FelixAntoine0708/projet_Formule_SAE/README.md

# PROJET FORMULE SAE AFFICHAGE (UdeS)
Le projet SAE pour UdeS Affichage

MicrosoftTeams-image

## Qu'est-ce qui si trouve
* A23 - Dossier qui contient ce que nous avons fait à la session d'autonme 2023 
* H24 - Dossier qui contient ce que nous avons fait à la session d'hiver 2024 
* Manuel_technique_CANVision_FINAL - Le manuel technique en PDF, docx et l'Evaluation des Couts du CANVision
