FelixAntoine0708/projet_Formule_SAE/H24/MATERIEL/README.md

* PCB : Contient le PDF et le fichier STEP 

* Boitier : Toutes les parties du boitier  

* Écran : Schéma électrique de l'écran, fiche technique de la famille d'écran Gen4-ESP32-RGB-Series et fiche technique du tca9554a.

* ESP32_S3R8 : Fiche technique et le manuel de référence technique du ESP32-S3.
