FelixAntoine0708/projet_Formule_SAE/H24/LOGICIEL/AFFICHAGE_SAE/README.md

# AFFICHAGE_SAE

## Ce qu'il contient

* AFFICHAGE_SAE_CAN_DESUET_ : Contiens la première version de l'affichage final qui est Désuet.

* DEMO_AFFICHAGE_POUR_UNI : Les démos d'affichages qui ont été montrés aux membres de l'université.

* Code_Final_CANVision_V1_FA : Code de l'affichage SAE final.

> [!TIP]  
> Dans les fichier de code il contient:
> * `4dArdUsd`:  Ficher d'extension graphique en Arduino
> * `4Dino` : Fichier de code de 4D system
> * `dat` : Fichier qui contient la position des widget sur l'écran en plain text
> * `gci` : Fichier qui contient la position des widget sur l'écran
> * `ino` : Fichier de code d'Arduino
> * `h` : Fichier qui contient les widgets sur l'écran uniquement
