FelixAntoine0708/projet_Formule_SAE/H24/MATERIEL/PCB/README.md

# PCB
PCB
## Ce qui contient

* _**PDF**_ : dossier qui contient les pieces du PCB `TJA1051T/3, 118`, `LM2675` et `ATM13-4P-BPM02`

* _**Fichier_Altium_PCB_V2**_ : Dossier qui contient les fichier pour voir dans Altium le PBC.

* _**PCB_V2_Final**_ : Dossier de fichier sources du PCB
