FelixAntoine0708/projet_Formule_SAE/H24/MATERIEL/Boitier/README.md

# Boitier
Boitier

## Ce qu'il si trouve

* _**3mf**_ : Dossier qui contient des fichier 3mf pour l'impression 3D

* _**STL**_ : Dossier qui contient des fichier STL pour la visualisation 3D
