FelixAntoine0708/projet_Formule_SAE/A23/CODE_PROJET/CAN_ESP32_PI/README.md

## Projet Final 
## Contenu

> [!NOTE]
> Le dossier ESP32 s'utilise sur **PlatformIO** <br />
> <br />
> ***include, lib, test*** <br />
> Ces dossiers n'ont rien à l'intérieur

* ESP32 - Dossier qui contient le code du ESP32-C3 Fonctionnel et Non fonctionnel 
* RASPBERRY_PI - Dossier qui contient le code du Rapsberry Pi Fonctionnel et Non fonctionnel
