FelixAntoine0708/projet_Formule_SAE/A23/CODE_PROJET/SPI_ESP32_PI/README.md

# Contenu
* CODE_FONCTIONNELLE
* CODE_NON_FOCTIONNELLE

> [!NOTE]
> C'est dossier, aux noms explicites, sont autant pour le ESP32-C3 que le Pi 3B.
