FelixAntoine0708/projet_Formule_SAE/H24/LOGICIEL/AFFICHAGE_SAE/DEMO_AFFICHAGE_POUR_UNI/README.md

# AFFICHAGE_SAE

## Ce qu'il contient

* AFFICHAGE_SAE_V1_ME_Gendron-Fontaine : Premier Affichage ME (DÉSUET)

* Code_Affichage_SAE_V1_FA_Guimont : Premier Affichage FA

* AFFICHAGE_SAE_V2 : Contiens le code d'une deuxième version de l'affichage SAE de M-E.

* Code_Affichage_SAE_V1_FA_Guimont_MODIF : Premier Affichage FA où les bogues sont corrigés

> [!TIP]  
> Dans les fichier de code il contient:
> * `4dArdUsd`:  Ficher d'extension graphique en Arduino
> * `4Dino` : Fichier de code de 4D system
> * `dat` : Fichier qui contient la position des widget sur l'écran en plain text
> * `gci` : Fichier qui contient la position des widget sur l'écran
> * `ino` : Fichier de code d'Arduino
> * `h` : Fichier qui contient les widgets sur l'écran uniquement
