FelixAntoine0708/projet_Formule_SAE/A23/CODE_PROJET/SERIAL_ESP32_PI/NON_FONCTIONNELLE/README.md

Ici se retrouvent les codes du ESP32-C3 et du Pi 3B pour une tentative de communication en serial avec les GPIO rx et TX.
Le serial étant non fonctionnel sur le Pi, cette idée a été embandonnée.
