FelixAntoine0708/projet_Formule_SAE/A23/CODE_PROJET/CAN_ESP32_PI/ESP32/NON_FONCTIONNELLE/README.md

Ici se trouve un code similaire à celui du ESP32-C3. Ce code est fait pour le ESP32-S3 qui contient aussi les drivers TWAI.
Pour une raison inexpliquée, le ESP32-S3 ne peut pas se servir du TWAI malgré qu'il soit inclus dans la fiche technique.
