FelixAntoine0708/projet_Formule_SAE/A23/CODE_PROJET/CAN_ESP32_PI/ESP32/FONCTIONNELLE/README.md

Ici se trouve le code du ESP32-C3 qui permet à ce dernier d'envoyer des trames CAN avec l'aide des drivers TWAI. Ce
code contient une partie pour la transmission de trame CAN et une autre pour la réception de ceux-ci. C'est ce code
qui nous permet de faire fonctionner notre prototype. Ce code est basé sur le framework de espressif32.
