FelixAntoine0708/projet_Formule_SAE/A23/CODE_PROJET/SPI_ESP32_PI/CODE_NON_FONCTIONNELLE/RASPBERRY_PI/README.md

# Contenu
* SLAVE_PI_V2.py <br />
  tentatives pour communiquer en SPI avec le ESP32. Ils doivent afficher les trames reçues dans un terminal. Ils sont non fonctionnels parce que le Raspberry Pi ne peut pas être un slave.
  
* SPI_PI_SLAVE.py <br />
  tentatives pour communiquer en SPI avec le ESP32. Ils doivent afficher les trames reçues dans un terminal. Ils sont non fonctionnels parce que le Raspberry Pi ne peut pas être un slave. mettre le Pi en slave pour la communication en SPI. Nous avons découvert que le Pi ne peut être qu'un master.
  
* SPI_PI_MASTER.py <br />
  tentatives de mettre le Pi en master. transmettre 0xAA au ESP32-C3 dans l'espoir que celui-ci les reçoive et les affiche dans un terminal.
  
* MASTER_PI_V2.py <br />
  tentatives de mettre le Pi en master. fait la même chose à l'exception que l'utilisateur entre les données à envoyer (entre 0 et 255).
  
* SPI_PI.py <br />
  les tentatives de communication en SPI. Afficher les données reçues dans un terminal.
  
* SPI_PY_AFF.py <br />
  les tentatives de communication en SPI. Afficher les données reçues avec la librairie Turtle.
