FelixAntoine0708/projet_Formule_SAE/A23/CODE_PROJET/SPI_ESP32_PI/CODE_NON_FONCTIONNELLE/ESP32_C3/README.txt

        Ce dossier contient les codes non fonctionnels du ESP32-C3. Les codes ESP32_SLAVE et SPI_ESP32 sont faits avec le framework espressif32.
