FelixAntoine0708/projet_Formule_SAE/A23/CODE_PROJET/SPI_ESP32_PI/CODE_FONCTIONNELLE/ESP32_C3/slave_simple_task/README.txt

    Ce code est un des multiples exemples que Arduino IDE a à offrir. Il permet au ESP32-C3 de communiquer avec le Pi 3B en SPI.
    J'ai modifié le code pour qu'il envoie les trois caractères suivant : H, L, O. Le ESP32-C3 est le SLAVE.
