FelixAntoine0708/projet_Formule_SAE/H24/README.md

# Dossier Hiver 2024

* LOGICIEL : Contiens tous les codes du projet.
* MATERIEL : Contiens tout les informations pour le matériel
