FelixAntoine0708/projet_Formule_SAE/A23/README.md

<h1> Dossier d'autonme 2023</h1>

## Que contient le dossier
* CAN_ESPIDF - Dossier qui contient le code d'envoie de l'autre équipe
* CODE_PROJET - Dossier qui contient le code d'affichage de notre équipe (Affichage avec Pi)
