FelixAntoine0708/projet_Formule_SAE/H24/LOGICIEL/README.md

# Logiciel

## Ce qu'il contient

* AFFICHAGE_SAE : Contiens des codes d'affichage SAE (Plusieurs choix pour client)

* CODE_AFFICHAGE_ET_CAN_DÉSUET_ : Contiens toutes les fonctions pour fusionner le code de l'affichage et le code du CAN. (DÉSUET)

* CODE_DE_TEST : Contiens les codes servant à faire des tests de toutes sortes (Affichage et CAN).

* LIBRAIRIE : Contiens la librairie (en zip) GFX4dESP32 pour l'écran ESP32-70CT.

* PDF_Logiciel : Contiens un user guide pour le Workshop4 et le manuel de la librairie GFX4dESP32.

* ID_CAN : Contiens les ID du CAN.
