FelixAntoine0708/projet_Formule_SAE/A23/CODE_PROJET/README.md

# Contenu
* **CAN_ESP32_PI** <br />
Ce dossier est celui que le code final est à l'intérieur **(FINAL)**

* **SERIAL_ESP32_PI/NON_FONCTIONNELLE** <br />
Ce dossier est du code qui transmet le message CAN en Rx, Tx. Il n'est pas fonctionel **(Back-up)**

* **SPI_ESP32_PI** <br />
Ce dossier est du code qui transmet le message CAN en SPI seulement avec 2 TJA1050. Il n'est pas fonctionel **(Back-up)**

* **TEST_BTN_ET_AFFICHAGE_PI** <br />
Ce dossier est du code qui affiche le message avec le bouton aussi. **(Test)**
