FelixAntoine0708/projet_Formule_SAE/H24/LOGICIEL/CODE_AFFICHAGE_ET_CAN_DÉSUET_/README.md

* CAN_FCT.cpp et CAN_FCT.h : Ce fichier contient toutes les fonctions qui seront utiles au projet au niveau du CAN (lecture de la trame CAN, vérification de la trame CAN, affichage des informations, etc.)

* ID_CAPT.h : Contiens les ID des capteurs. (ID TEMPORAIRE)

* FCT_AFF.cpp et FCT_AFF.h : Contiens les fonctions utiles pour l'affichage (setup, affiche, update_affichage).

* CONST_AFF.h : Contiens les constantes utiles pour l'affichage (position en X et Y des boutons pour l'instant).

* 13_MARS_DESUET_ : Code désuet pour le CAN.

* 17_AVRIL_DESUET_ : Code désuet pour le CAN.

* 3_MAI_DESUET : Code désuet pour le CAN.

* 17_MAI_DESUET : Code désuet pour le CAN.
