FelixAntoine0708/projet_Formule_SAE/H24/LOGICIEL/ID_CAN/README.md

* ID_CAPT.h : Ce fichier d'entête contient toutes les constantes pour les capteurs. Les ID sont temporaires.
