FelixAntoine0708/projet_Formule_SAE/H24/LOGICIEL/AFFICHAGE_SAE/AFFICHAGE_SAE_CAN_DESUET_/README.md

* AFFICHAGE_SAE_CAN_V_0_0_1 : Première version de l'affichage finale. Fait par M_E.
