FelixAntoine0708/projet_Formule_SAE/H24/LOGICIEL/CODE_AFFICHAGE_ET_CAN_DÉSUET_/13_MARS_DESUET_/README.md

* CAN_FCT_MODIF.cpp : Ce fichier contient toutes les fonctions modifiées qui seront utiles au projet (lecture de la trame CAN, vérification de la trame CAN, affichage des informations, etc.). Les fonctions ont été modifiées pour les adapter à l'affichage utilisé. "verif_trame" et "affiche_data" ne sont pas utilisés pour l'instant.

* CAN_FCT_MODIFF.h : Ce fichier d'entête contient toutes les prototype de fonctions qui seront utiles au projet (lecture de la trame CAN, vérification de la trame CAN, affichage des informations, etc.). Les fonctions ont été modifiées pour les adapter à l'affichage utilisé. "verif_trame" et "affiche_data" ne sont pas utilisés pour l'instant.

* ID_CAPT.h : Ce fichier d'entête contient tous les ID des capteurs sous forme de constante. !!!!!!!POUR L'INSTANT, LES ID SONT TEMPORAIRES!!!!!!

* ID_CAPT_DRIVE.h : Ce fichier d'entête contient tous les ID utilisé par la drive sous forme de constante.
