FelixAntoine0708/projet_Formule_SAE/H24/LOGICIEL/AFFICHAGE_SAE/Code_Final_CANVision_V1_FA/Code_Final_CANVision_V1_FA.ImgData/images.bmp

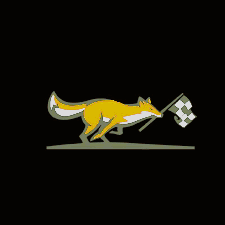
H24/LOGICIEL/AFFICHAGE_SAE/Code_Final_CANVision_V1_FA/Code_Final_CANVision_V1_FA.ImgData/images.bmp
