FelixAntoine0708/projet_Formule_SAE/H24/MATERIEL/PCB/PCB_V2_Final_/04 - ASSEMBLY/PCB_MCP_Final_BOM REV 2.00.xlsx

Bill of Material
Board | CAN_transciever |  | Concepteur Principal |  | Felix-Antoine Guimont |  |  | 2
Cours | Projet_Fin_DEC |  | Date du projet |  | 11 fevrier 2024 |  |  | 00
Département | Technologies du génie électrique |  | Date de génération du BOM |  | 4/14/2024
Révision | #NAME? |  | Heure de génération du BOM |  | 10:37 PM
Nombre de PCB | 1 |  | Variant |  | None
Item Number | Designator | Layer | Description | Comment | #Column Name Error:' Package / Case | #Column Name Error:' Supplier 1 | #Column Name Error:' Supplier Part Number 1 | Quantity | Quantity Total | #Column Name Error:' Note
 | C1, C8, C9 | Top | CAP ALUM 100UF 20% 50V SMD | 100 uF |  |  |  | 3 | #REF!
 | C2 | Top | Chip Capacitor, 10 nF, +/- 10%, 50 V, -55 to 125 degC, 0603 (1608 Metric), RoHS, Tape and Reel | 10 nF |  |  |  | 1 | #REF!
 | C3, C7 | Top | Automotive Ceramic Capacitor, 0805, 100nF, 10%, X7R, 15%, 100V | 0.1uF |  |  |  | 2 | #REF!
 | C4, J1, L1, R1, R2, R3, R4 | Top |  | 68 uF, ATM13-4P-BM02, 47uF, 10, 270, 120 |  |  |  | 7 | #REF!
 | C5, C6 | Top | CAP CER 100PF 50V C0G/NPO 0805 | 100 pF |  |  |  | 2 | #REF!
 | D1 | Top | LED GREEN CLEAR 0805 SMD | 10mA FC / 2.2VF |  |  |  | 1 | #REF!
 | D2 | Top | DIODE SCHOTTKY 40V 1A SOD123F | SS14FL |  |  |  | 1 | #REF!
 | J2 | Top | Flex Connector, 0.50mm Pitch, Height 2.00mm, Right angle, Slider type, ZIF, Upper contact, 30 position , Without MYLAR | F32Q-1A7H1-11030 |  |  |  | 1 | #REF!
 | R5 | Top | Chip Resistor, 1 KOhm, +/- 1%, 125 mW, -55 to 155 degC, 0805 (2012 Metric), RoHS, Tape and Reel | 1K |  |  |  | 1 | #REF!
 | U1 | Top | SIMPLE SWITCHER® Power Converter High Efficiency 1A Step-Down Voltage Regulator, 8-pin Narrow SOIC, Pb-Free | LM2675M-5.0/NOPB |  |  |  | 1 | #REF!
 | U2 | Top | High-Speed CAN Transceiver, 3 to 5 V, 8-Pin SOIC (SOT96-1), RoHS, Tape and Reel | TJA1051T/3,118 |  |  |  | 1 | #REF!
Commentaires ou instruction spécialies
