FelixAntoine0708/projet_Formule_SAE/H24/MATERIEL/Boitier/3mf/Porte_V1.3mf

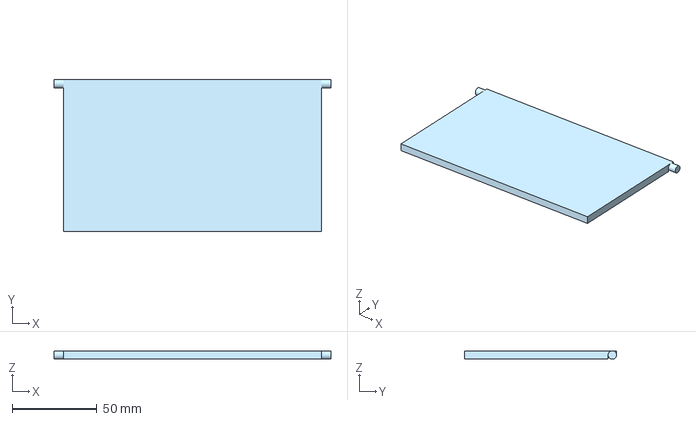
[picture p25: CAD file, 2024-02-28]
H24/MATERIEL/Boitier/3mf/Porte_V1.3mf
163.8 x 90.0 x 5.00 mm
