FelixAntoine0708/projet_Formule_SAE/H24/MATERIEL/Boitier/3mf/Boitier_V1.3mf

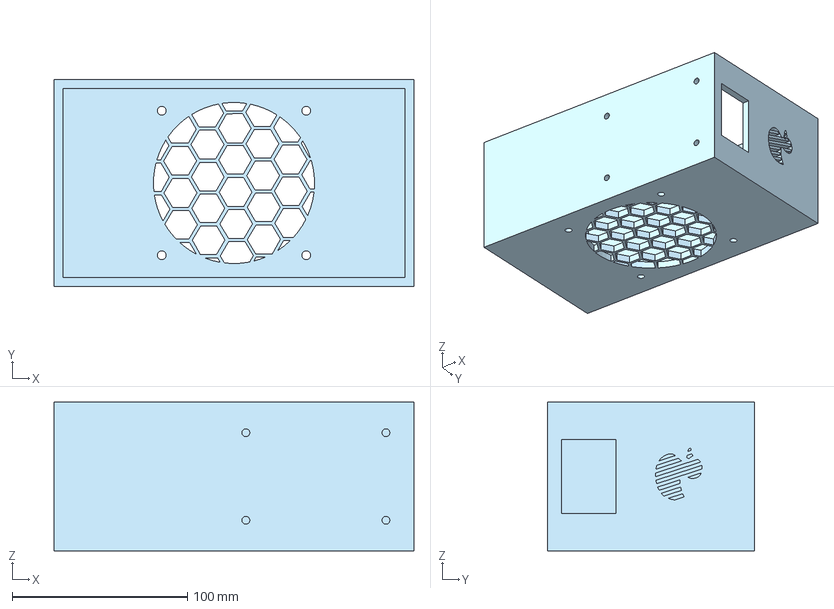
[picture p26: CAD file, 2024-02-28]
H24/MATERIEL/Boitier/3mf/Boitier_V1.3mf
205.6 x 118.1 x 85.0 mm
