FelixAntoine0708/projet_Formule_SAE/H24/MATERIEL/Boitier/3mf/Devant_V1.3mf

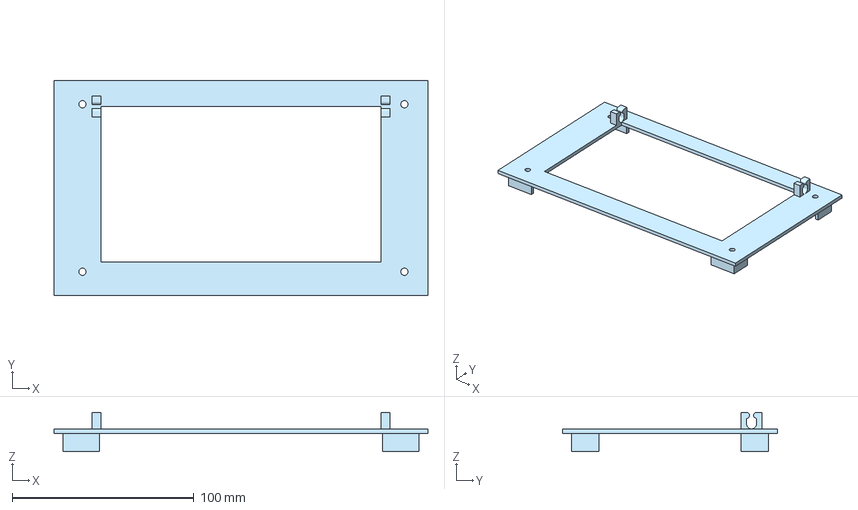
[picture p27: CAD file, 2024-02-28]
H24/MATERIEL/Boitier/3mf/Devant_V1.3mf
205.6 x 118.1 x 21.5 mm
