FelixAntoine0708/projet_Formule_SAE/(list of files, cad)

Other CAD files:
H24/MATERIEL/Boitier/STL/Boitier_V1.stl
H24/MATERIEL/Boitier/STL/Devant_V1.stl
H24/MATERIEL/Boitier/STL/Porte_V1.stl
H24/MATERIEL/PCB/PCB_V2_Final_/05 - 3D MODEL/PCB_MCP_Final_PCB REV 2.00.x_t
