FelixAntoine0708/projet_Formule_SAE/H24/LOGICIEL/CODE_DE_TEST/CODE_PICASO_CORRIGER_TEST_AFFICHAGE/README.md

Ici se trouve le dossier "TEST_AFF_PICASO" qui contient le code de test de l'affichage uLCD-32PT.

Le code se trouve dans le fichier "NoName1.4Dg".

Noname1.4Dg est un programme d'exploration des capacités du logiciel "4D Workshop 4 IDE". En gros, ce programme
affiche un thermomètre et une switch. Quand nous touchons la switch, le thermomètre affichera soit 100 C ou 10 C.
La switch est activé en touchant l'écran tactile. Il y a un label qui affiche la dernière position en x connus.
