FelixAntoine0708/projet_Formule_SAE/H24/LOGICIEL/CODE_DE_TEST/TEST_FPS/README.md

#TEST_FPS

## Ce qu'il contient

* TEST_FPS : Le premier code pour observer la fluidité de l'écran. Le fichier des widgets (le .cgi) fait environ 60 Mb.
