FelixAntoine0708/projet_Formule_SAE/H24/MATERIEL/PCB/PCB_V2_Final_/04 - ASSEMBLY/PCB_MCP_Final_PCB ASSEMBLY REV 2.00.PDF

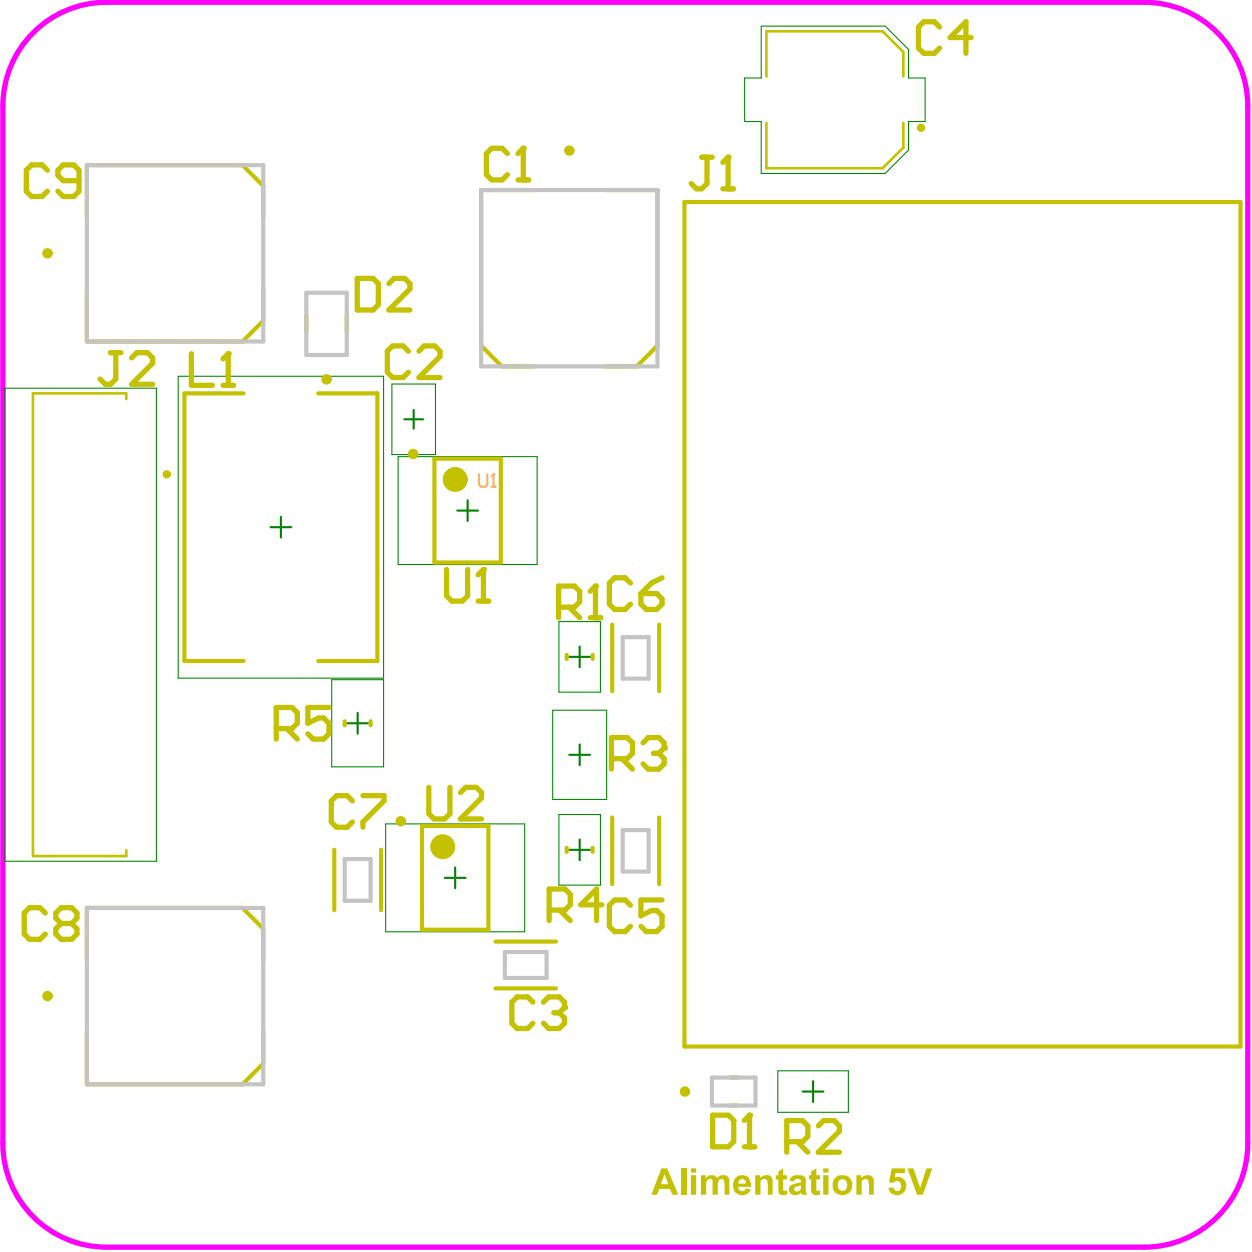
[picture p28: page 1]

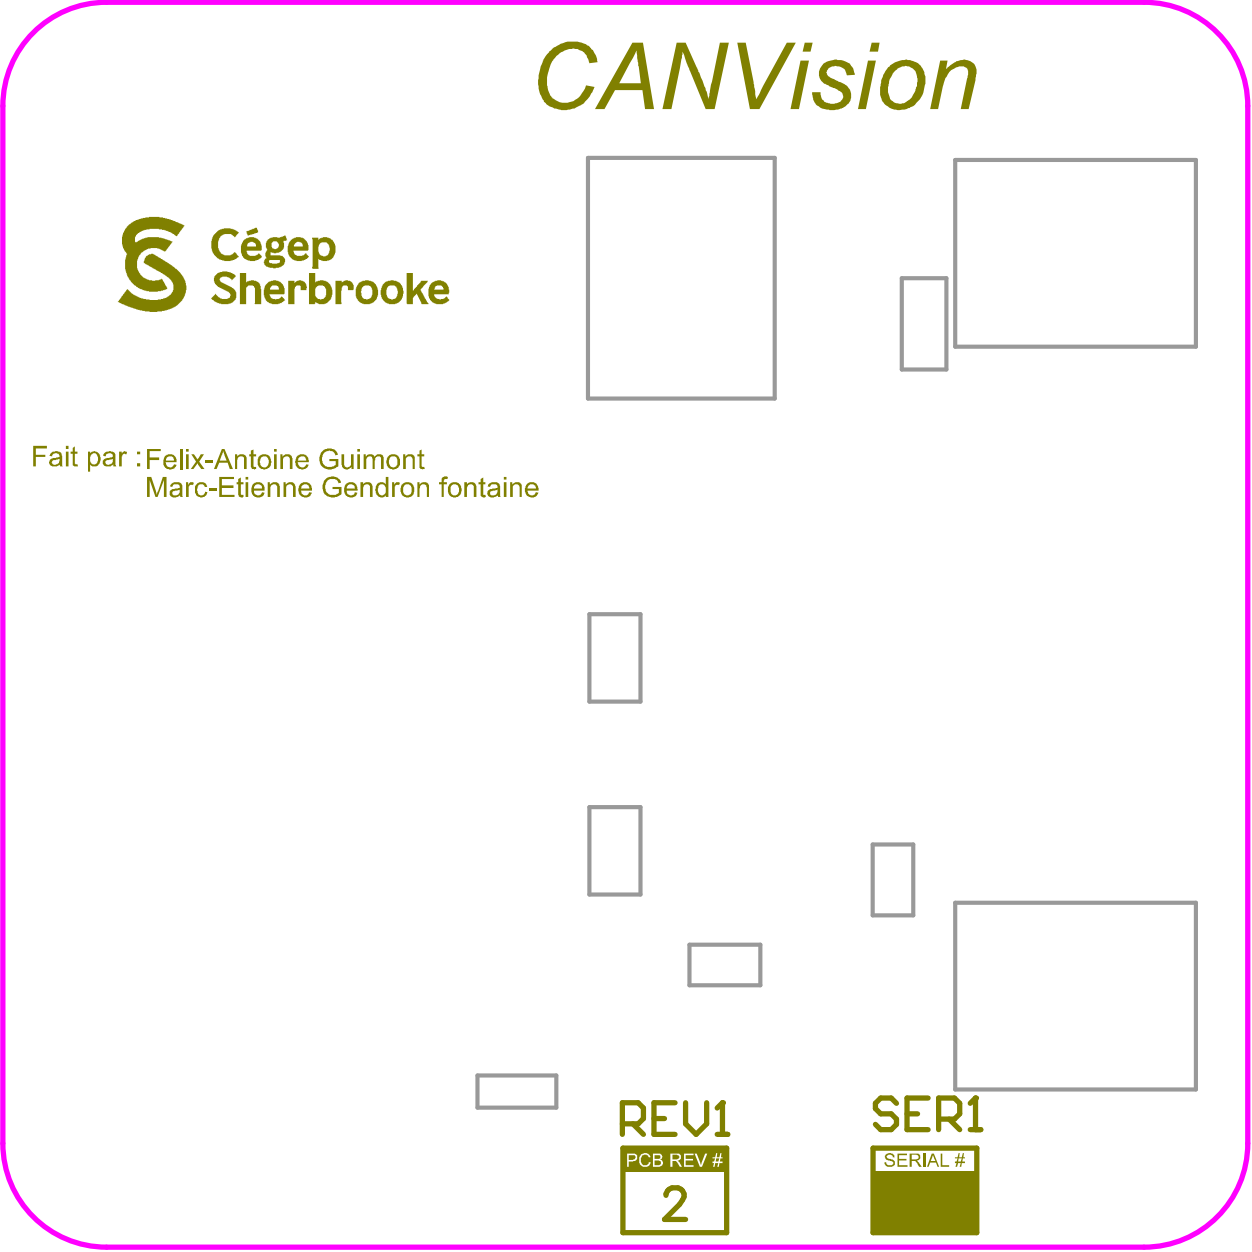
[picture p29: page 2]

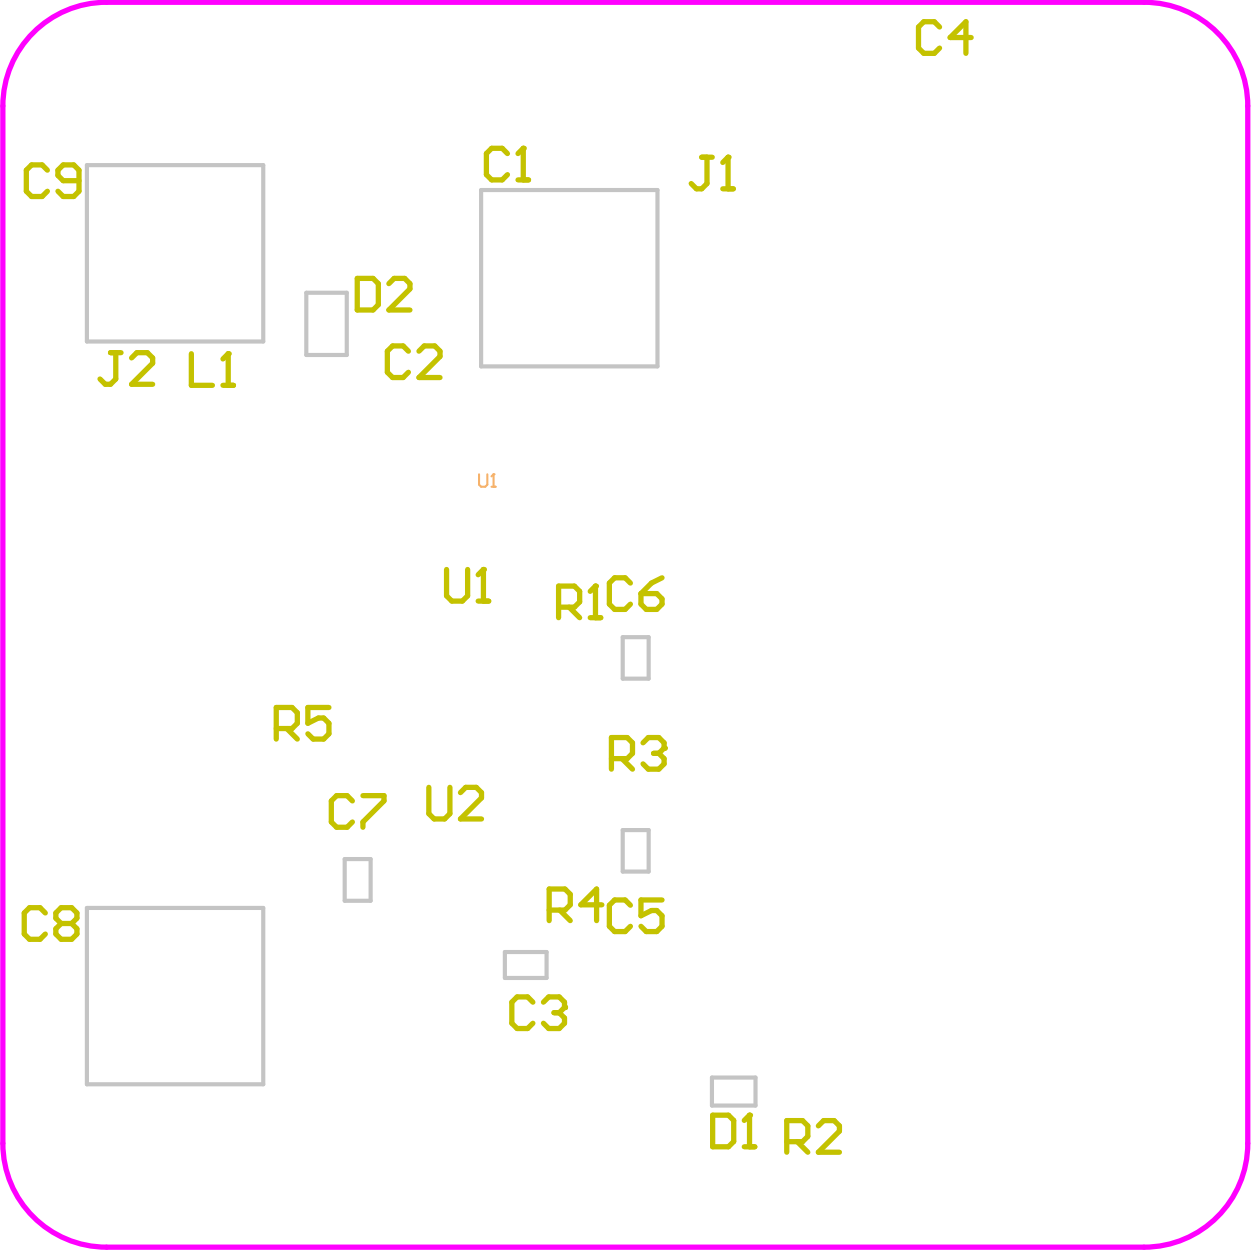
[picture p30: page 3]

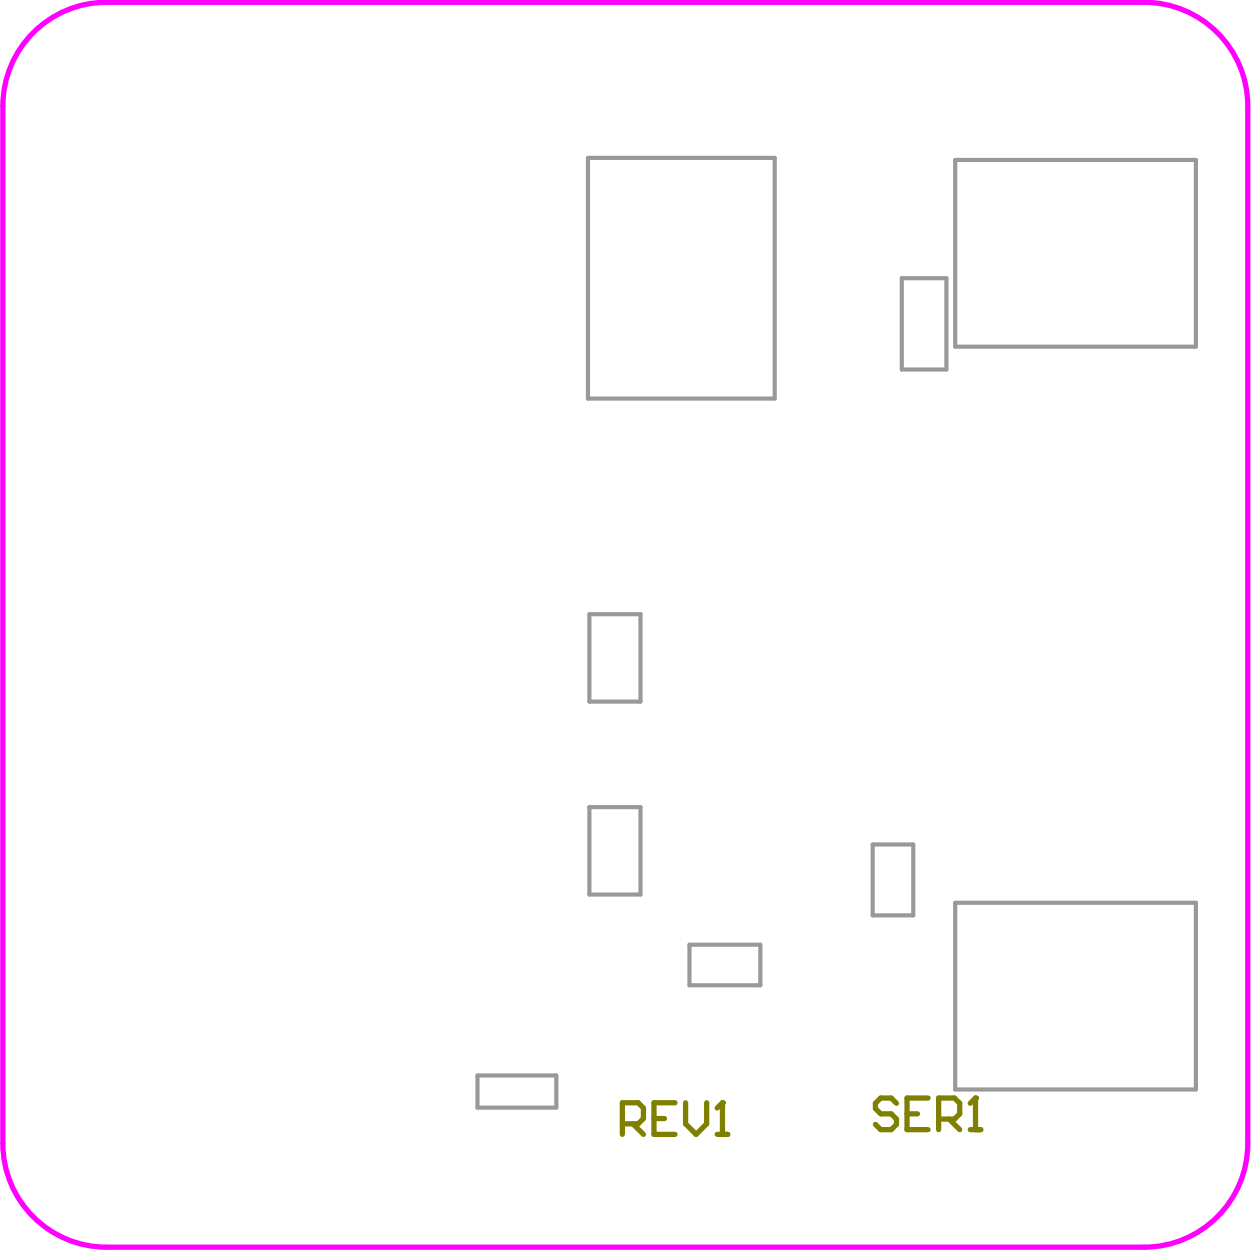
[picture p31: page 4]

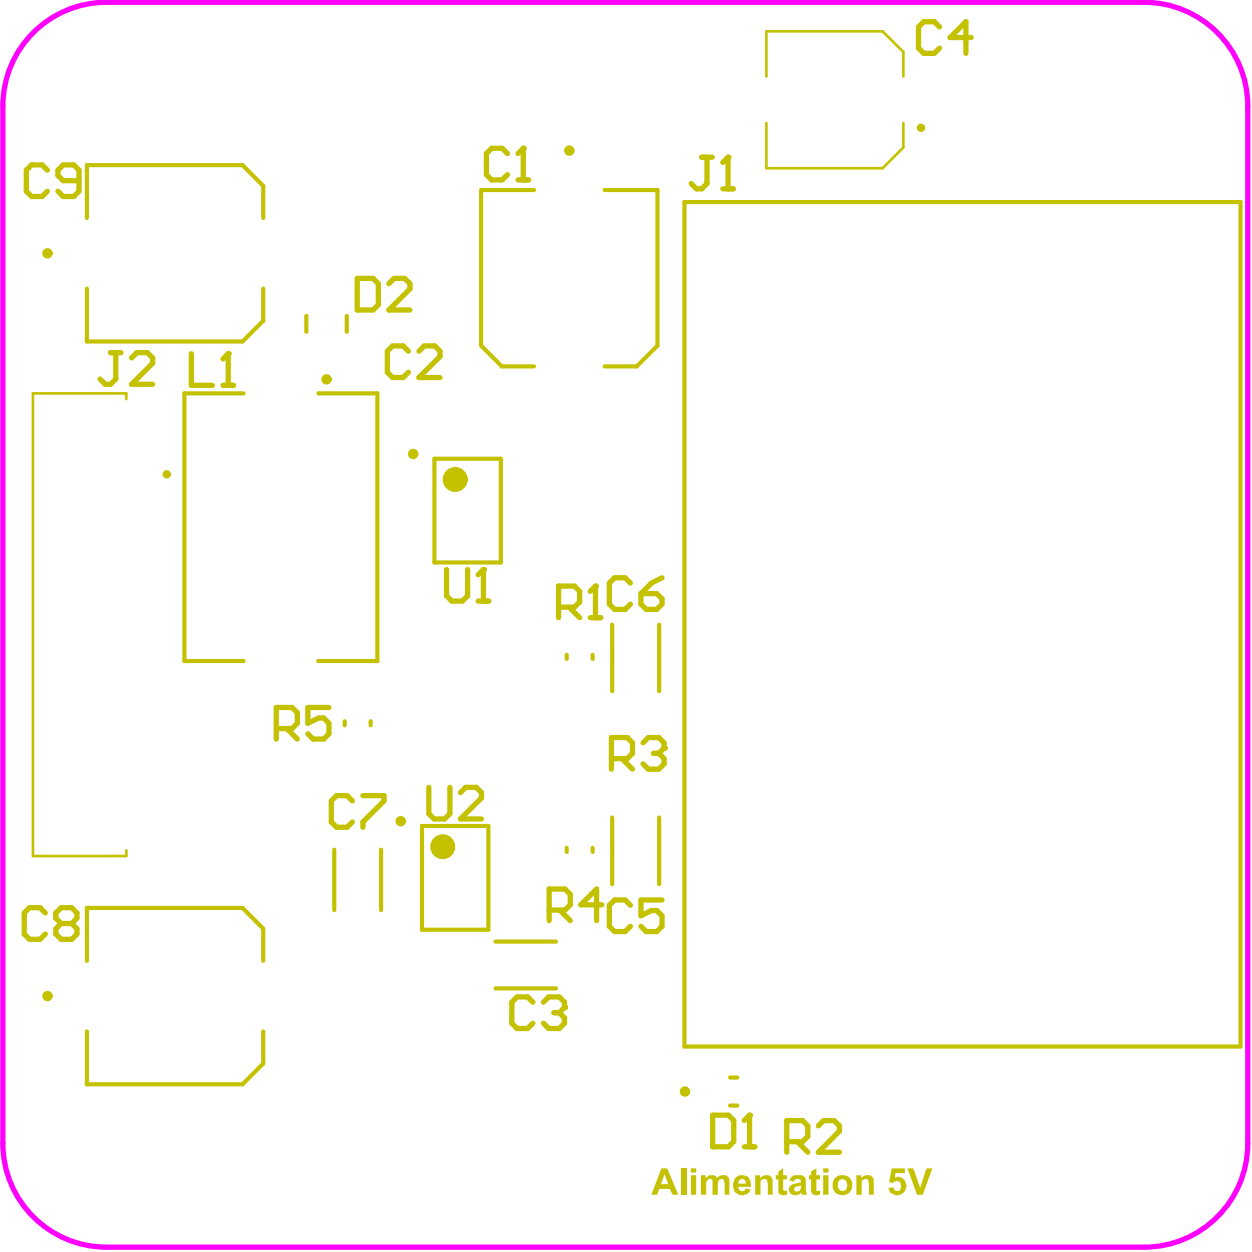
[picture p32: page 5]

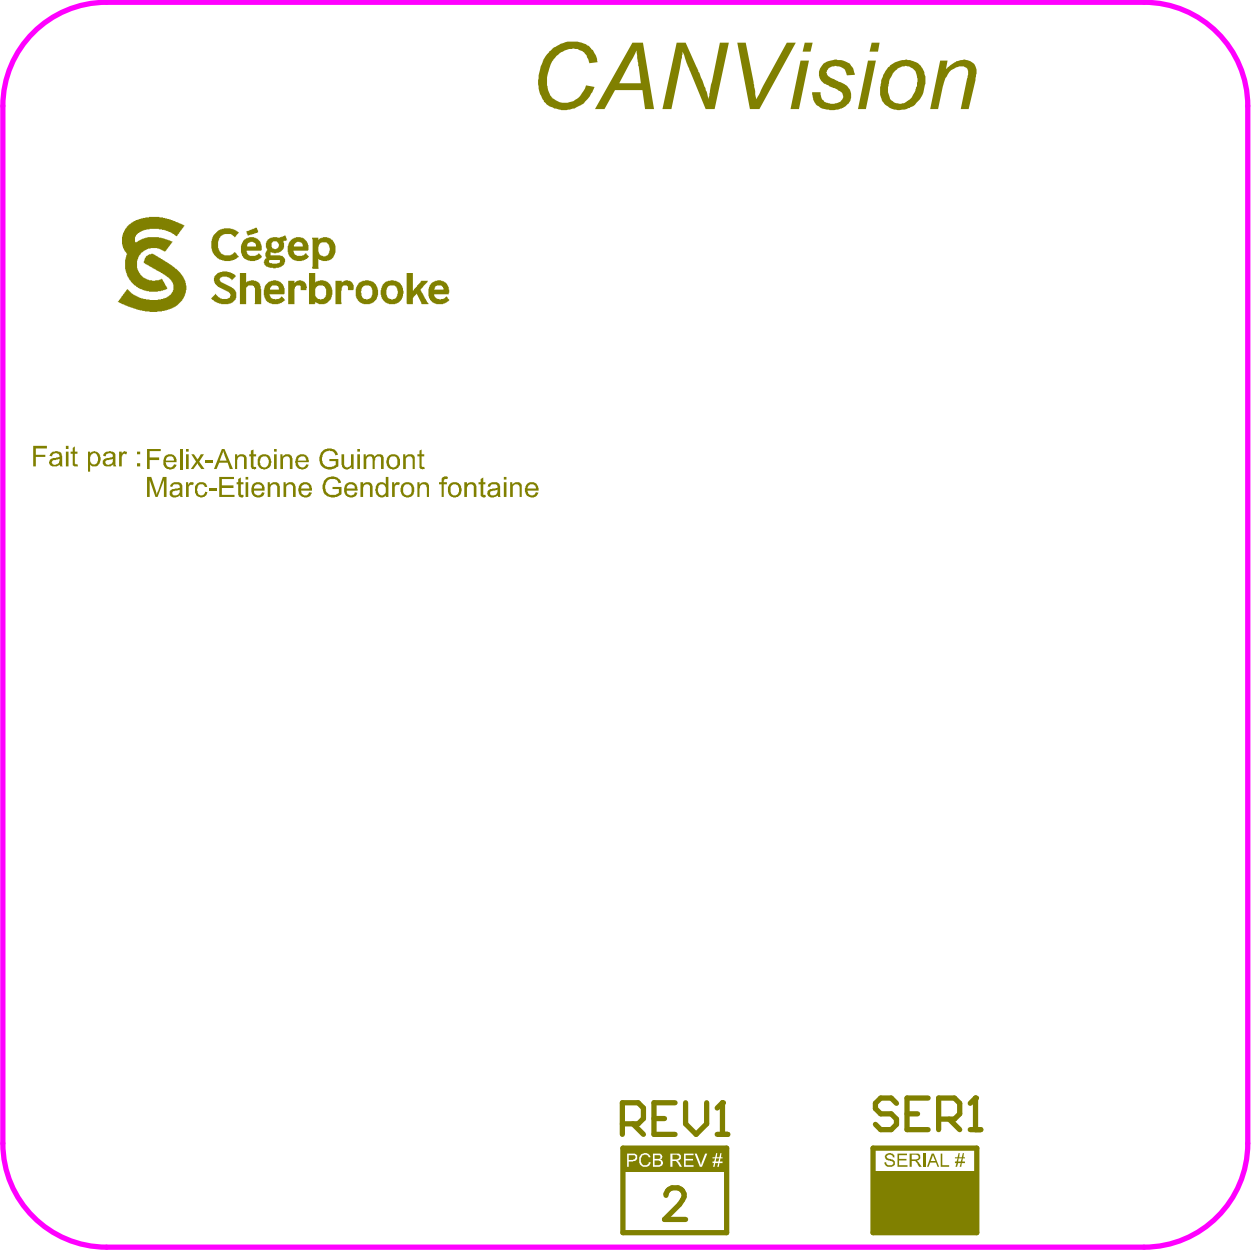
[picture p33: page 6]

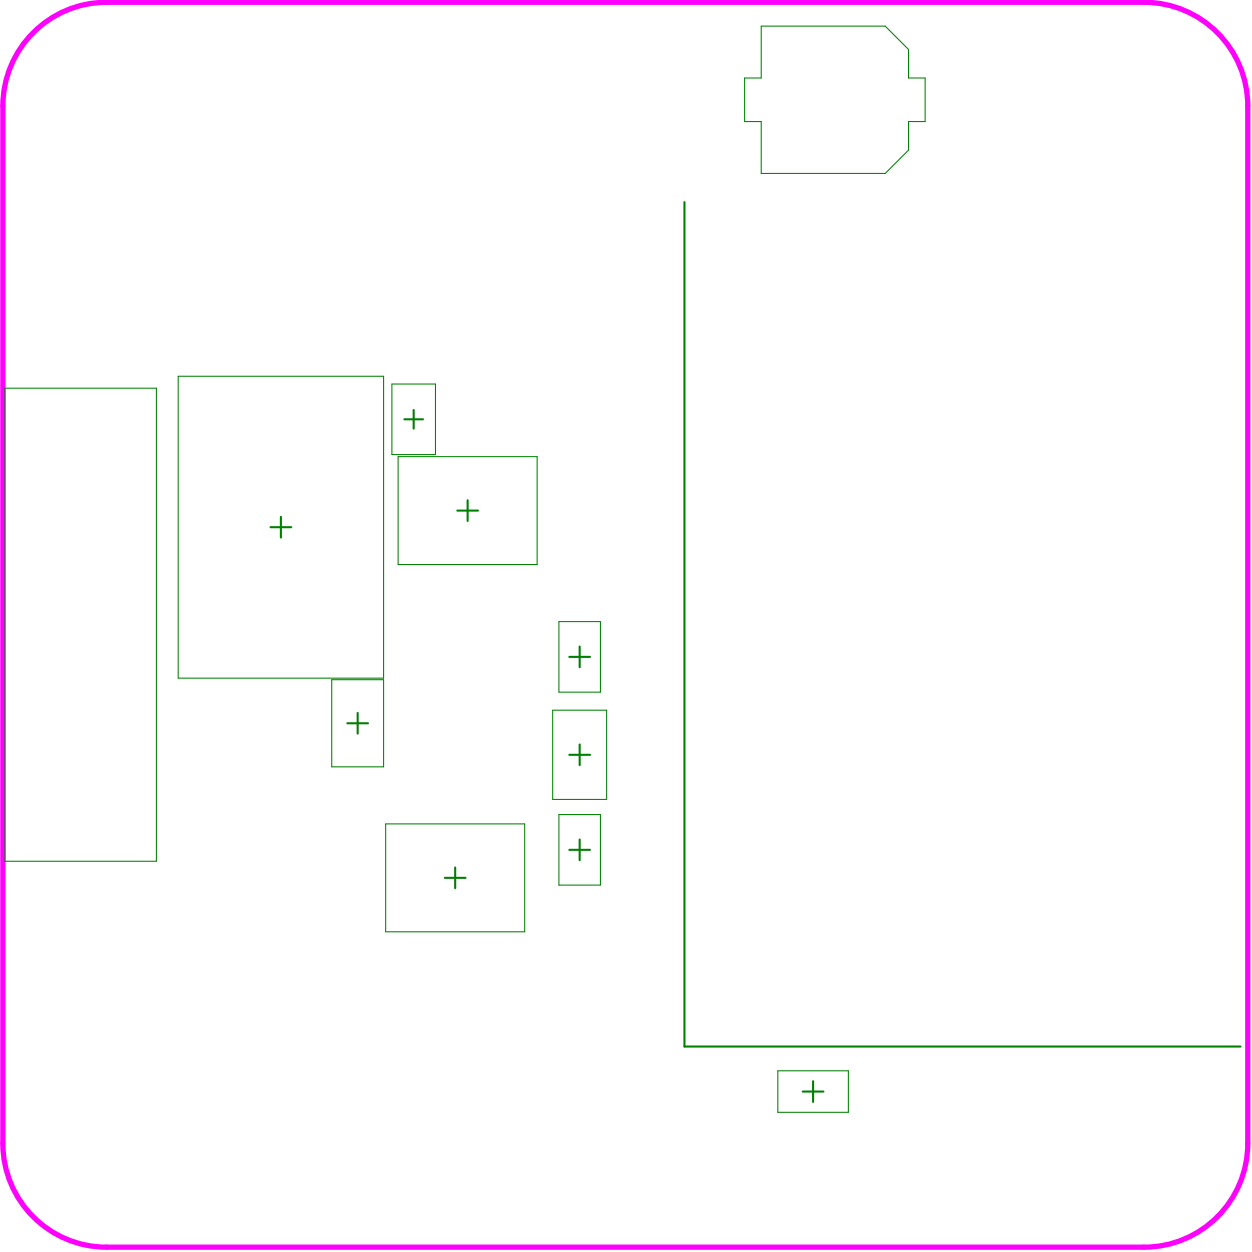
[picture p34: page 7]
