FelixAntoine0708/projet_Formule_SAE/H24/MATERIEL/PCB/PCB_V2_Final_/01-3 - STENCIL FAB/PCB_MCP_Final_STENCIL PRINT REV 2.00.PDF

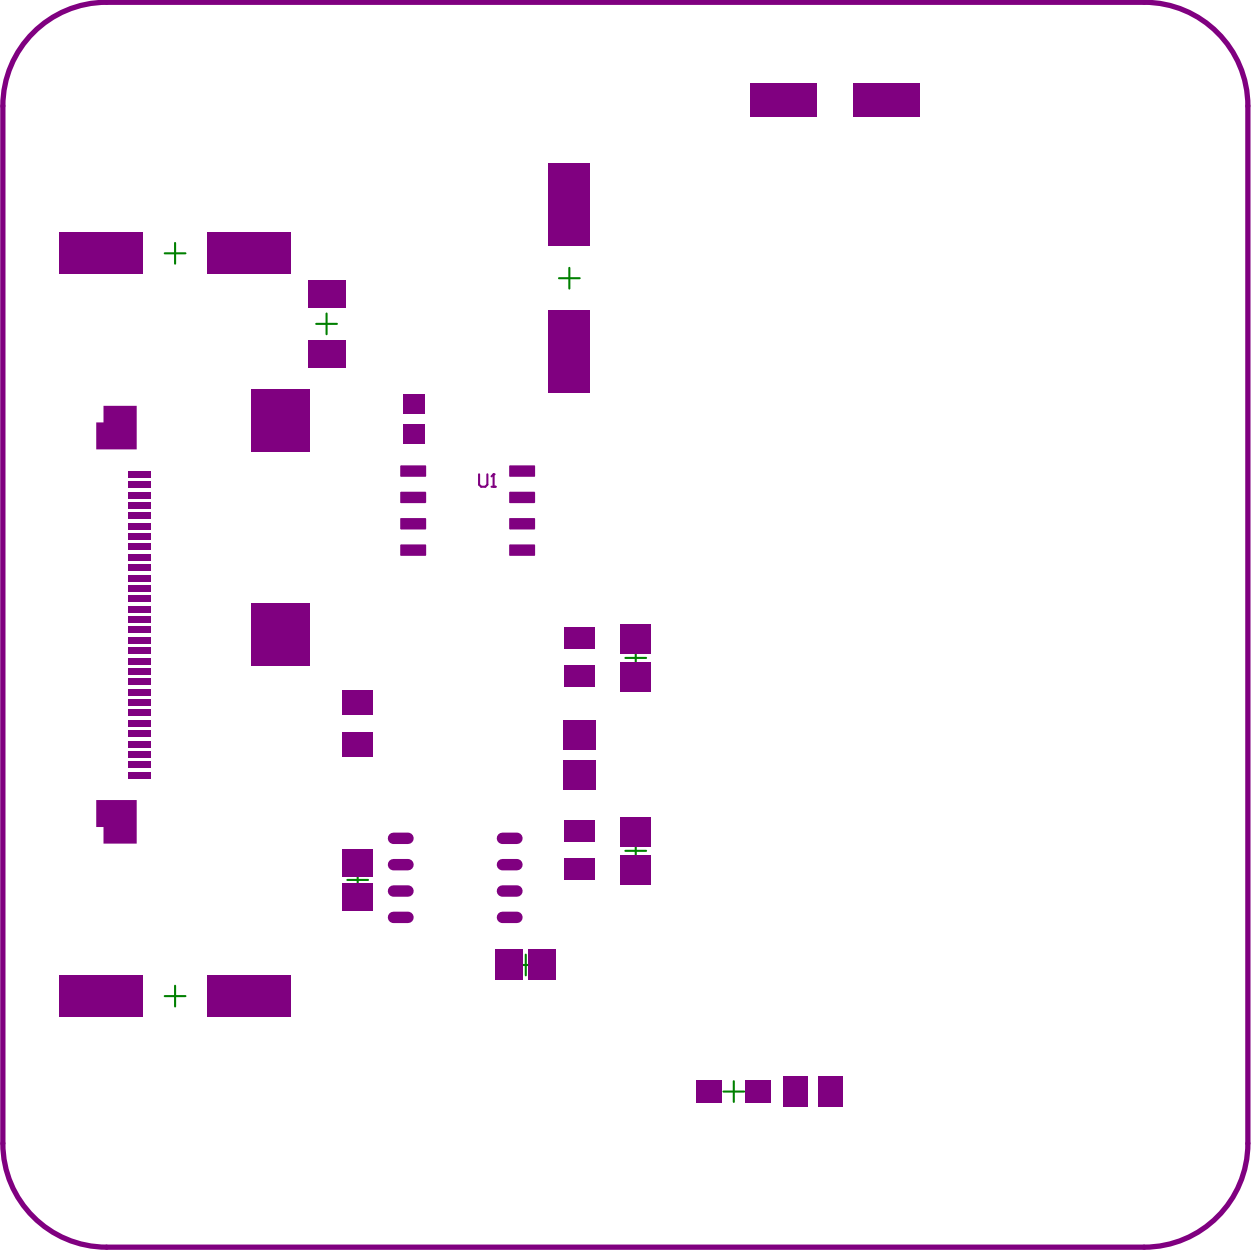
[picture p35: page 1]

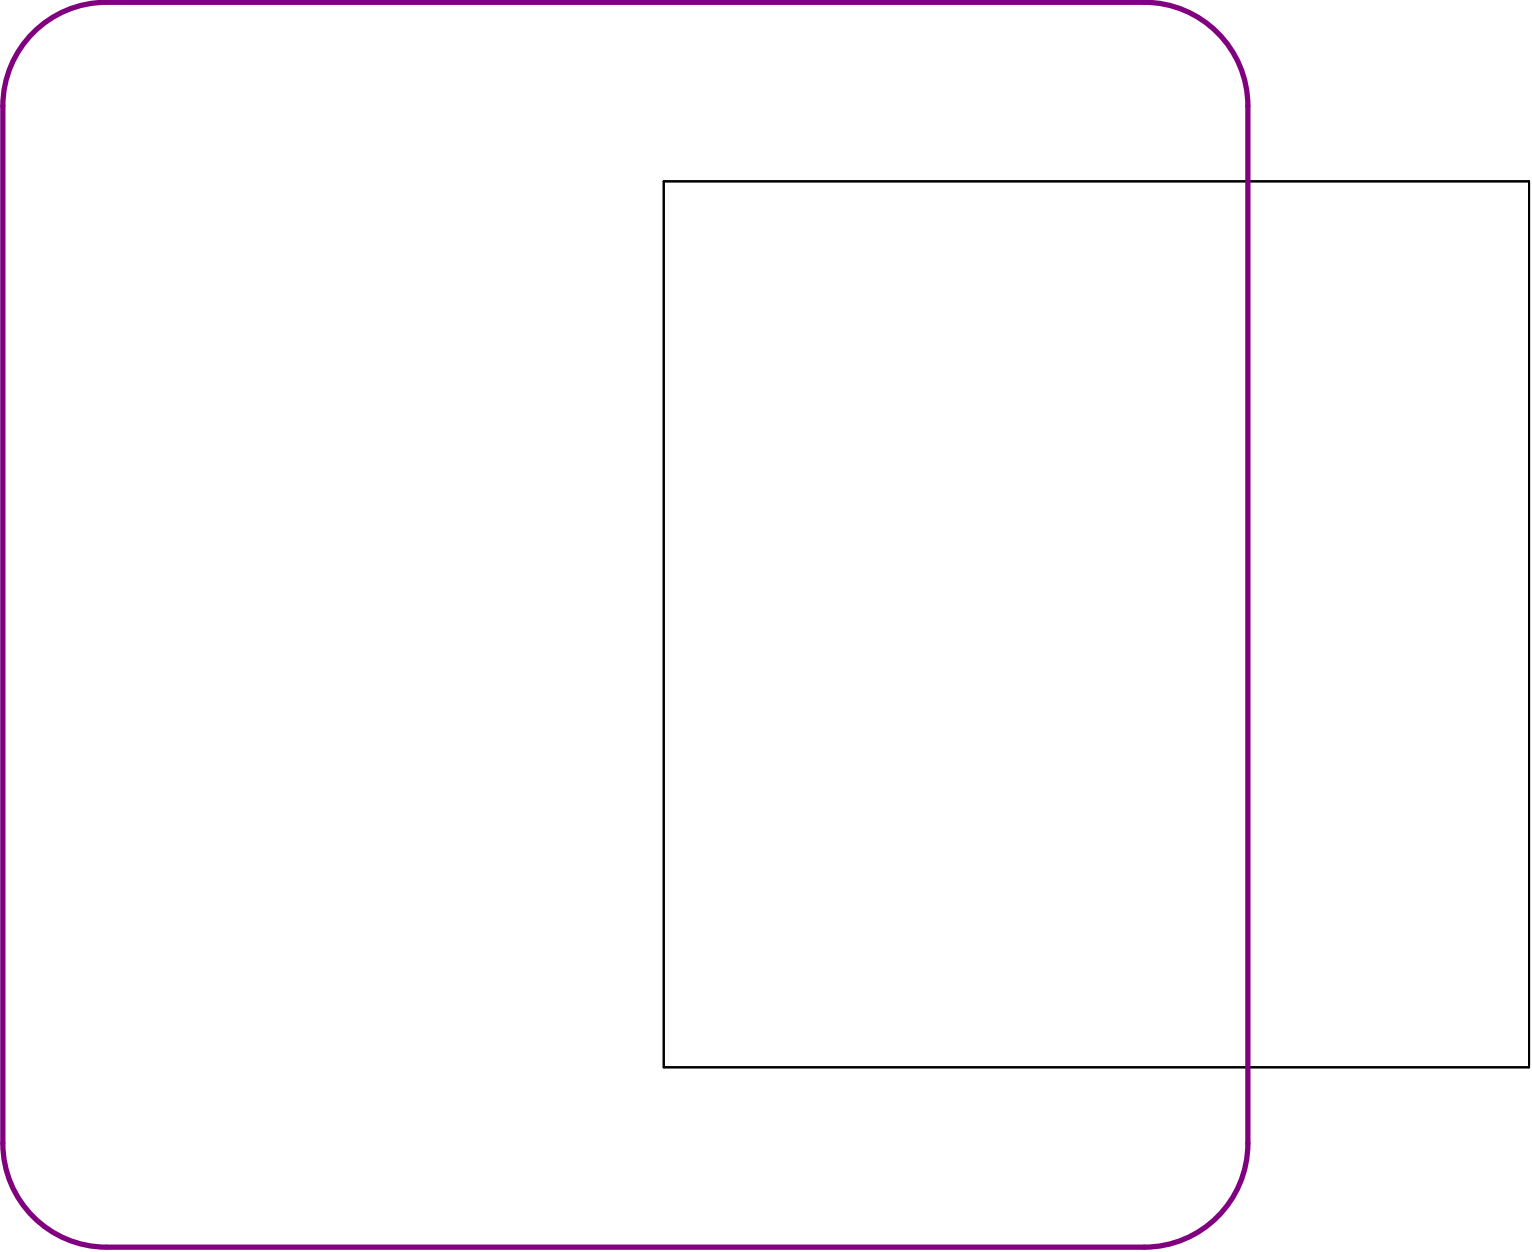
[picture p36: page 2]
