FelixAntoine0708/projet_Formule_SAE/H24/MATERIEL/PCB/PCB_V2_Final_/02 - PDF/PCB_MCP_Final_PCB PRINT REV 2.00.PDF

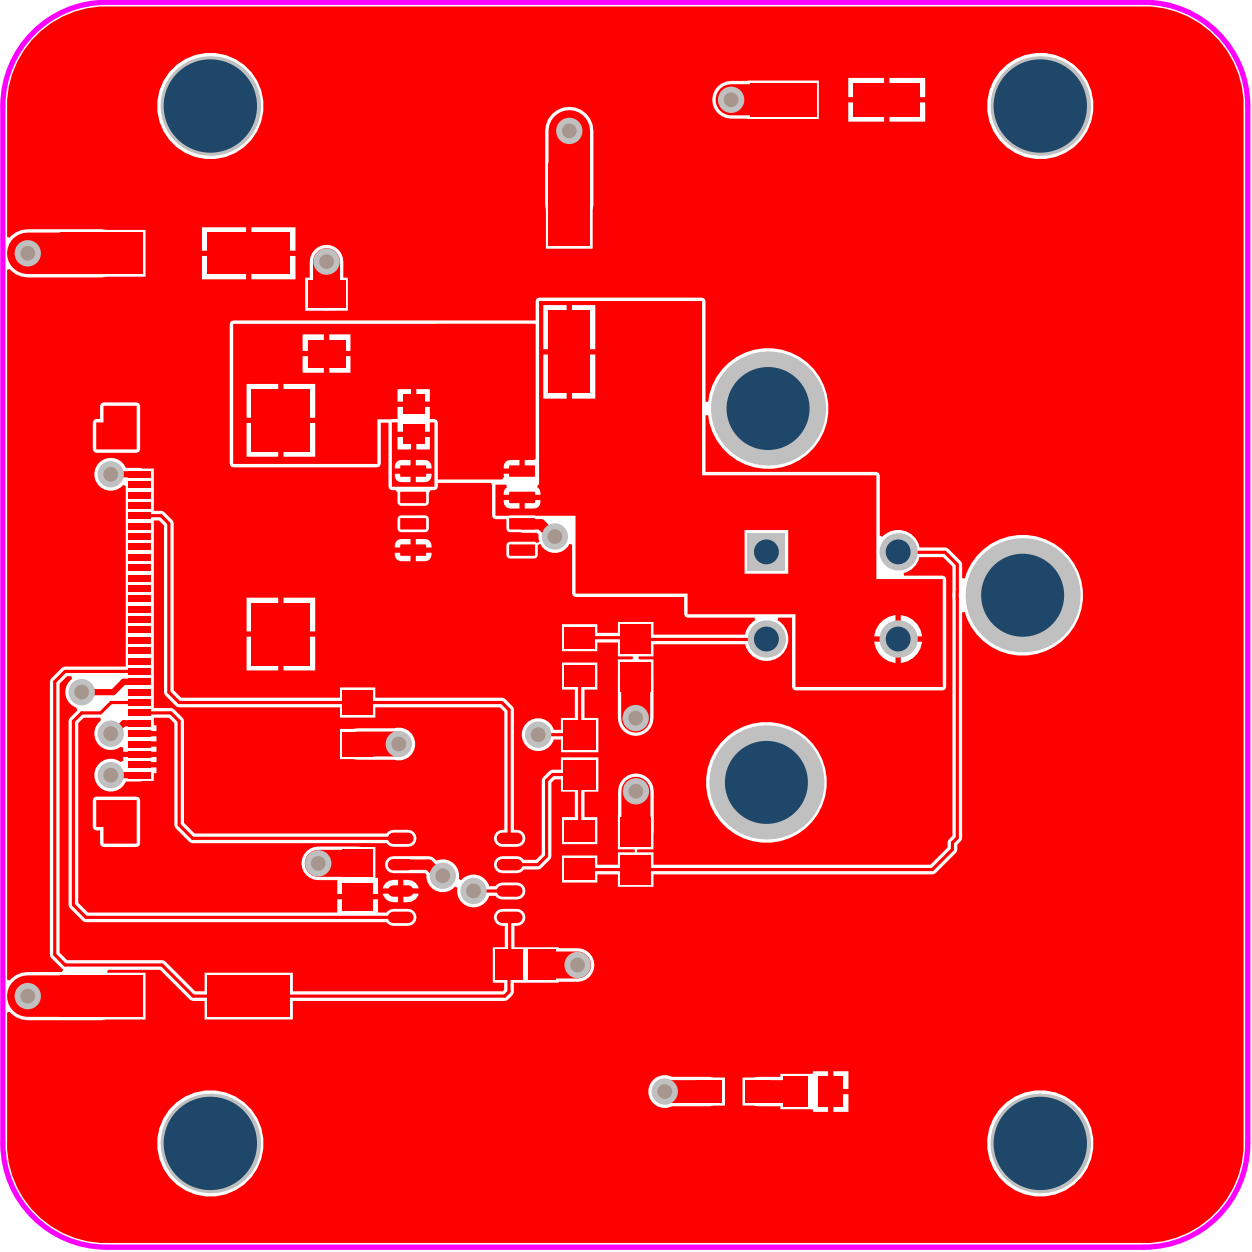
[picture p37: page 1]

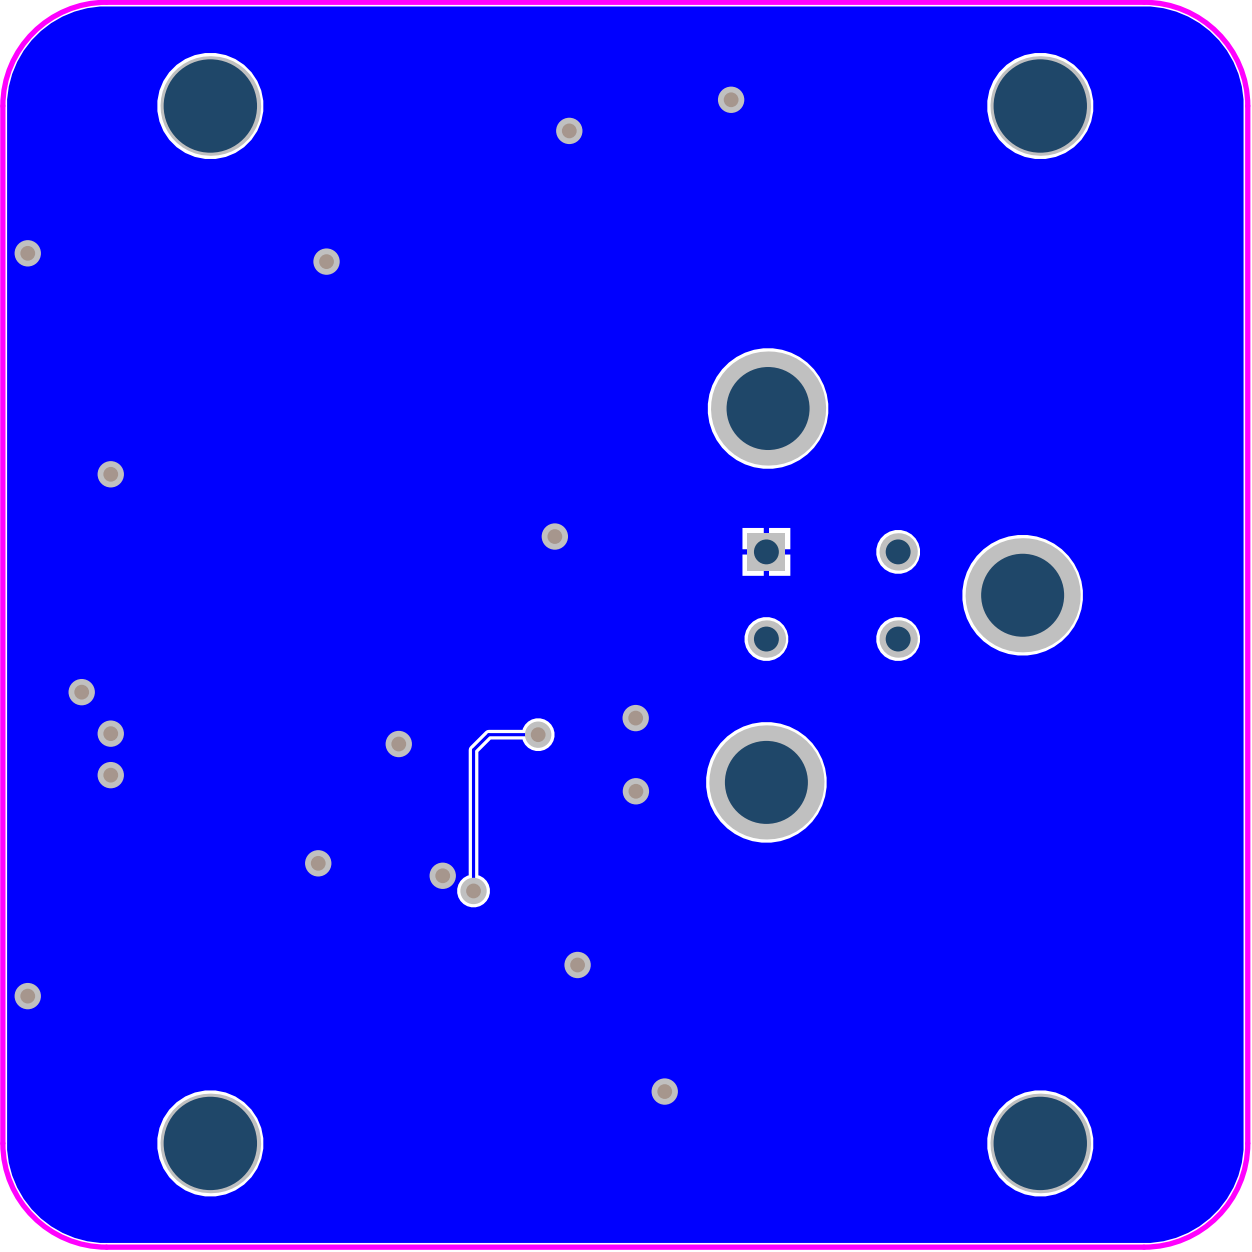
[picture p38: page 2]

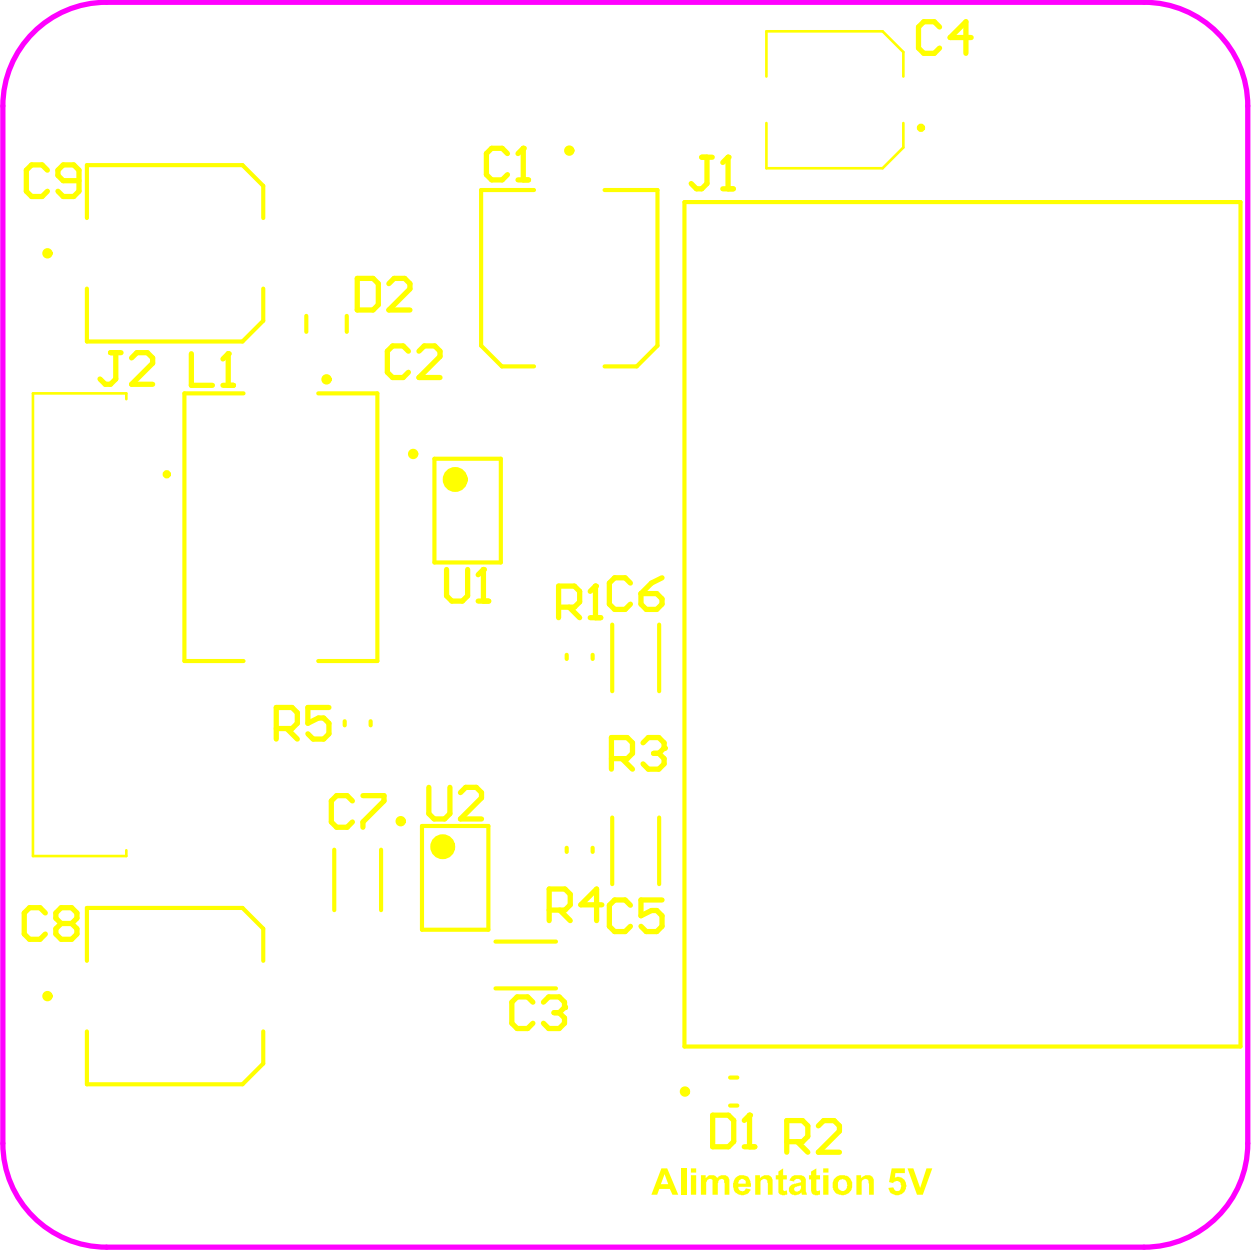
[picture p39: page 3]

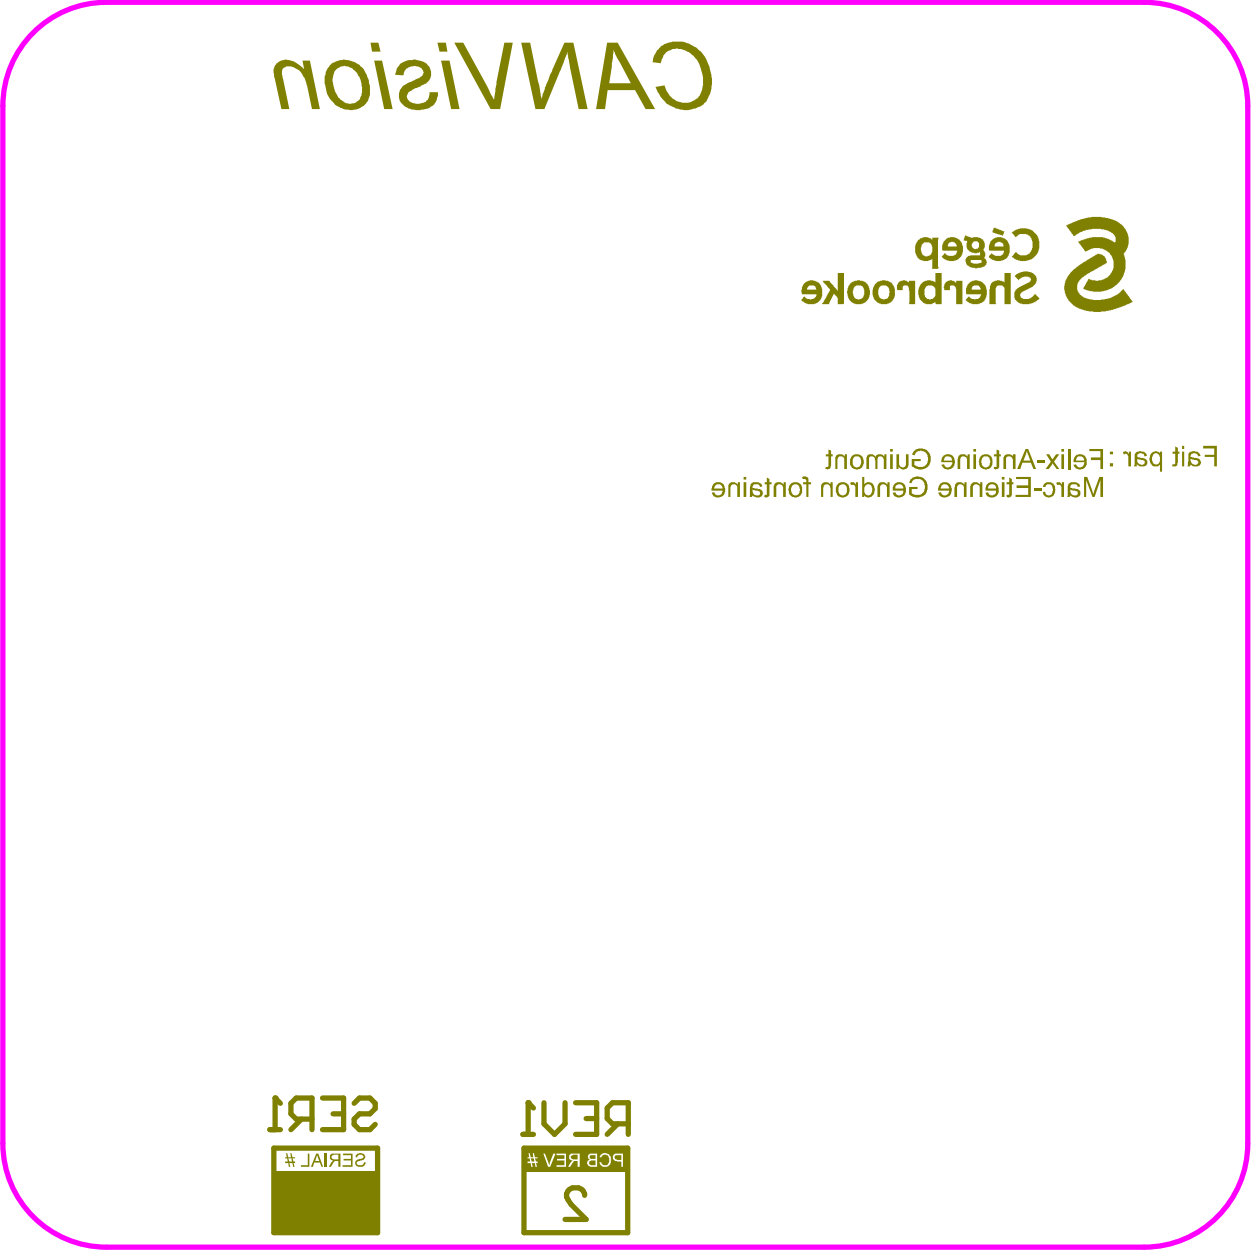
[picture p40: page 4]

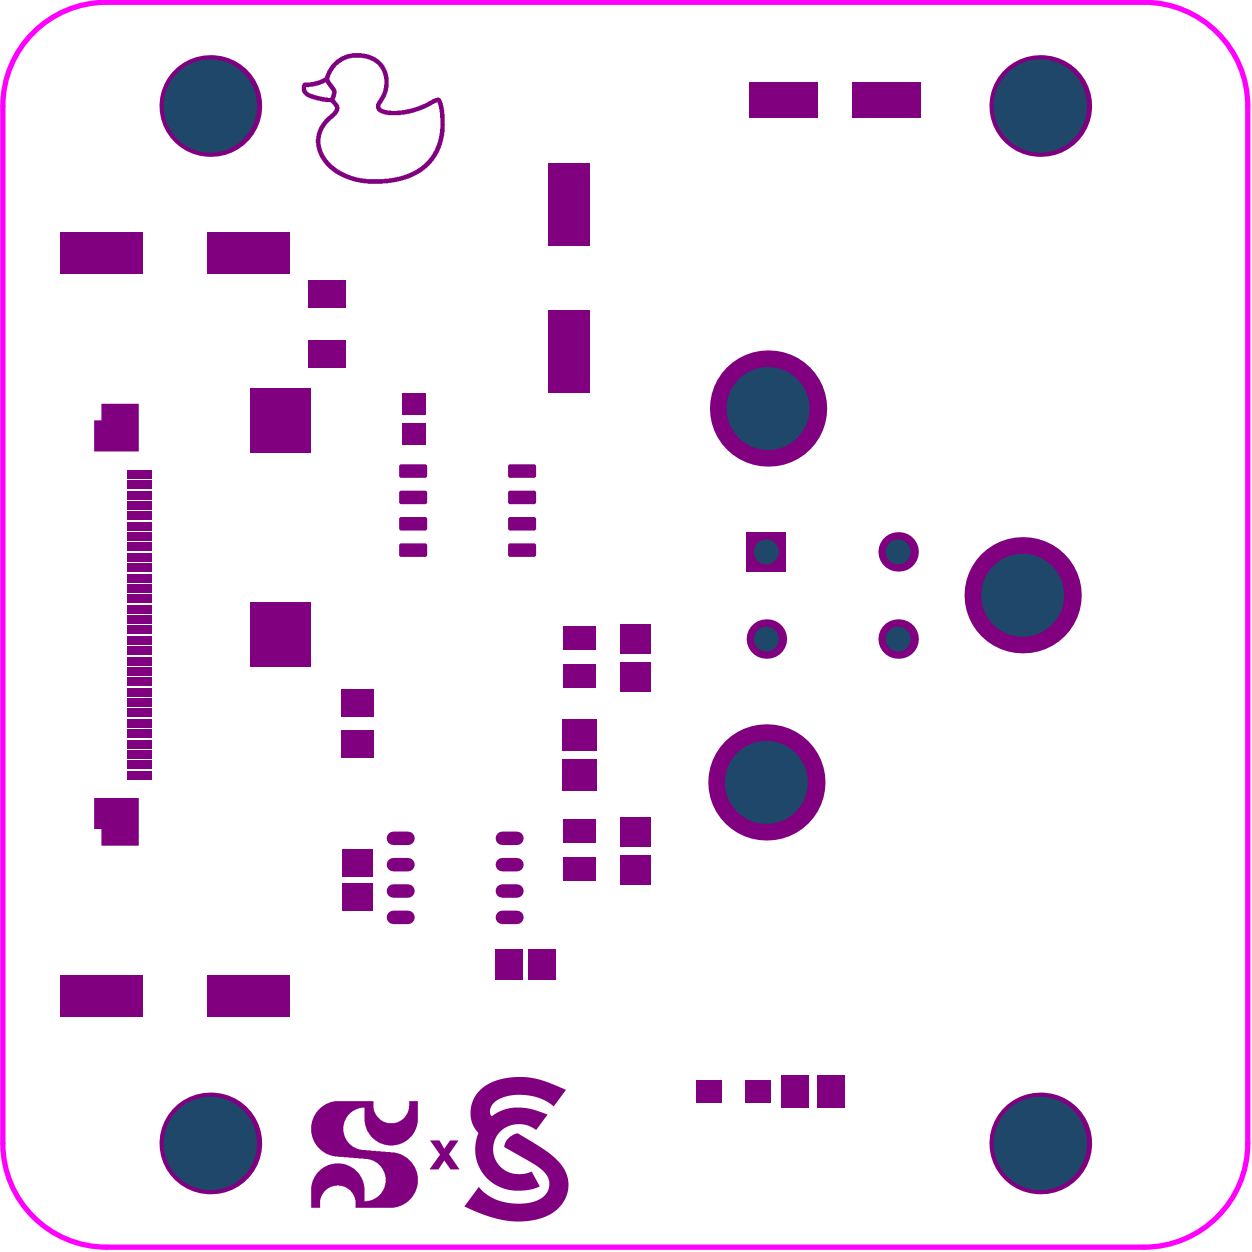
[picture p41: page 5]

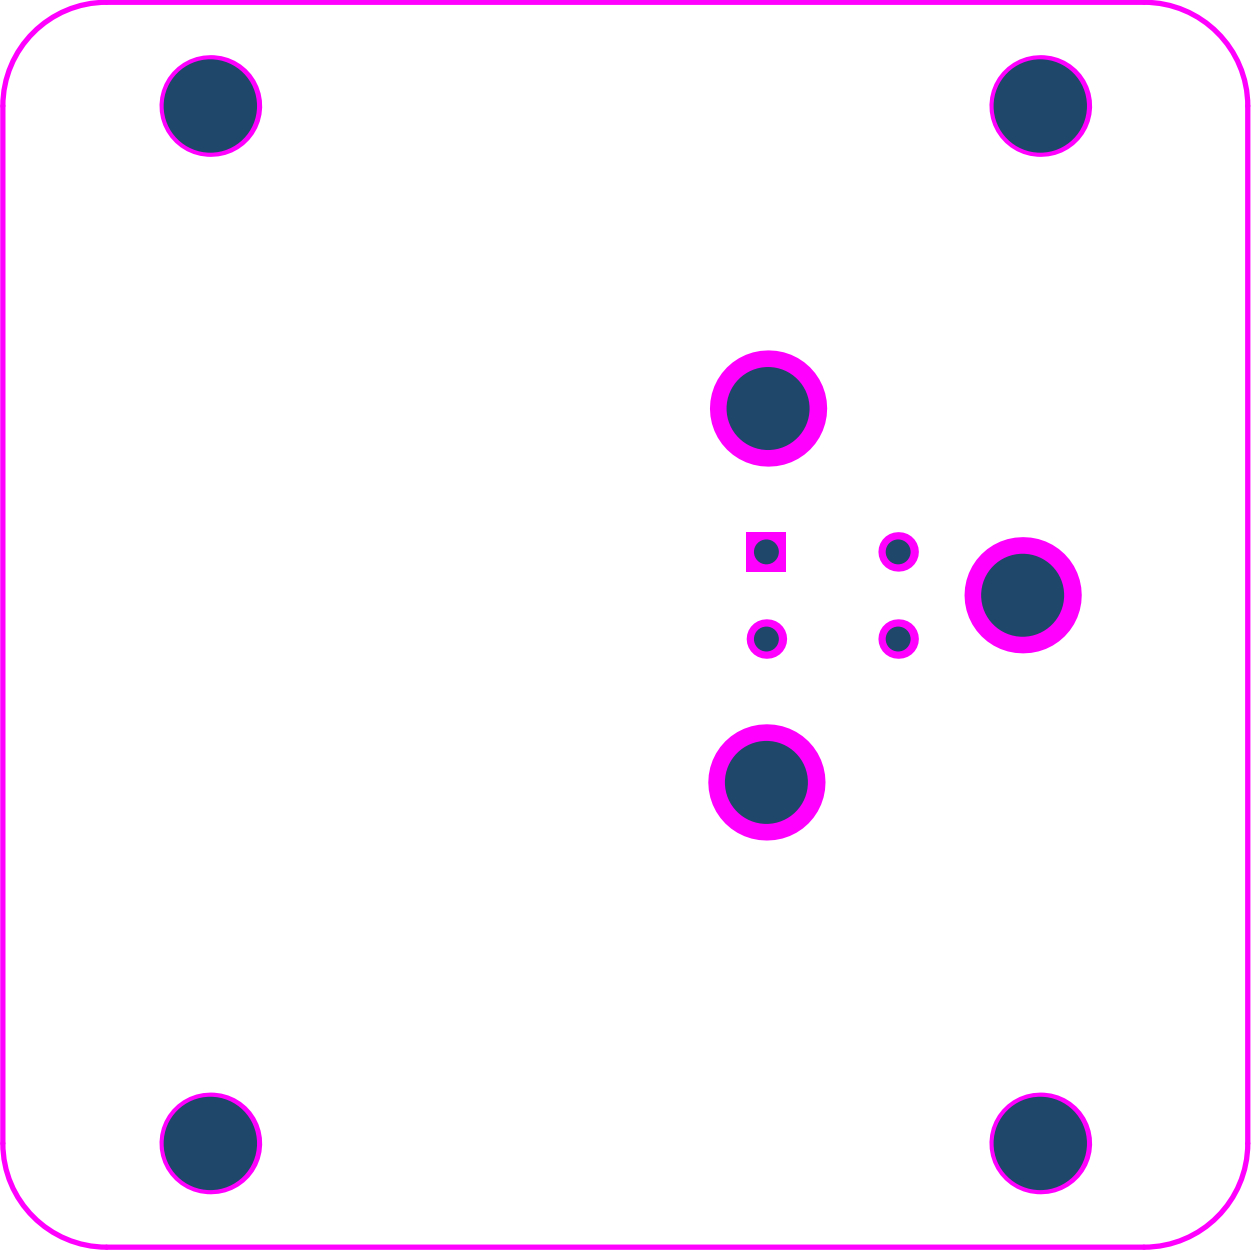
[picture p42: page 6]

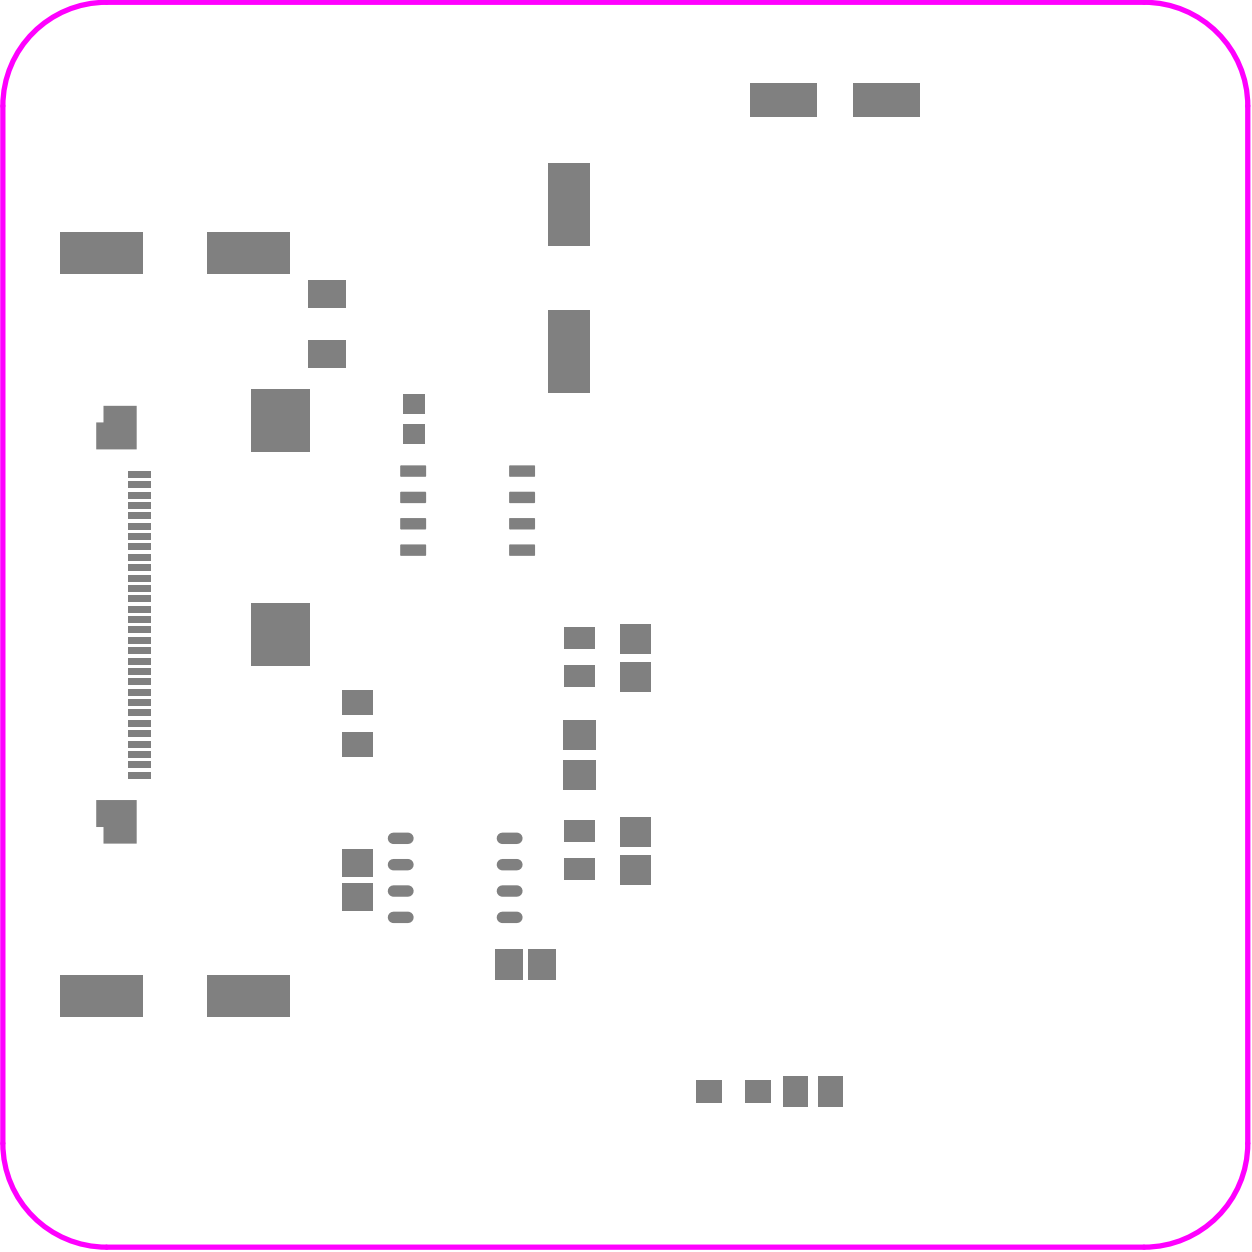
[picture p43: page 7]

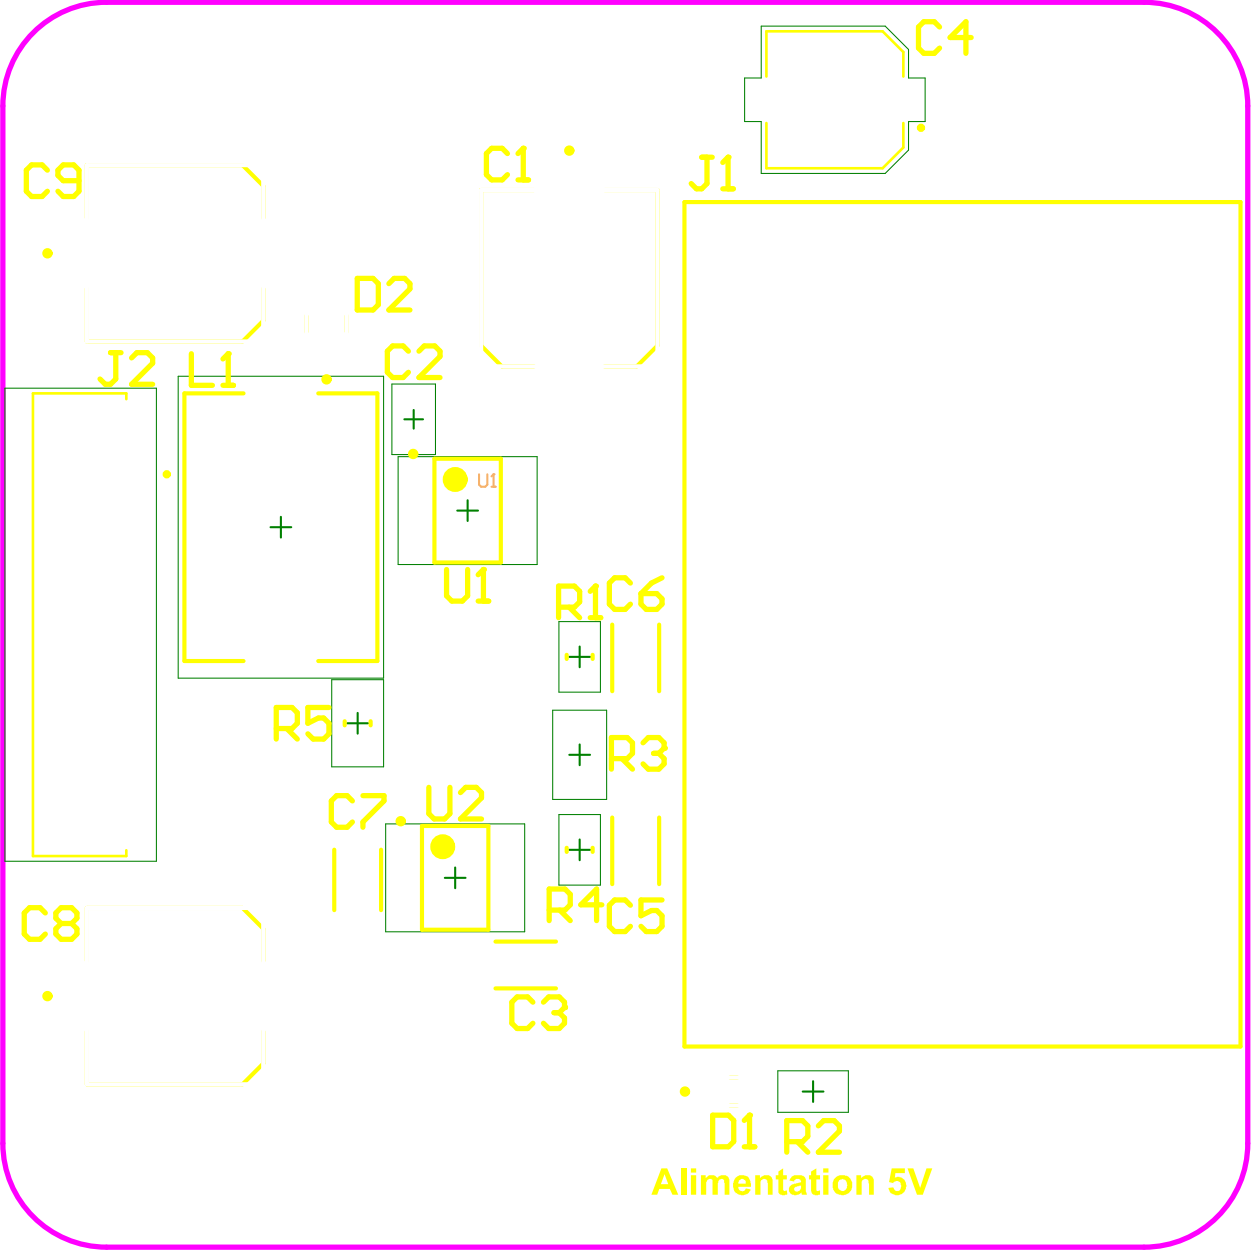
[picture p44: page 9]

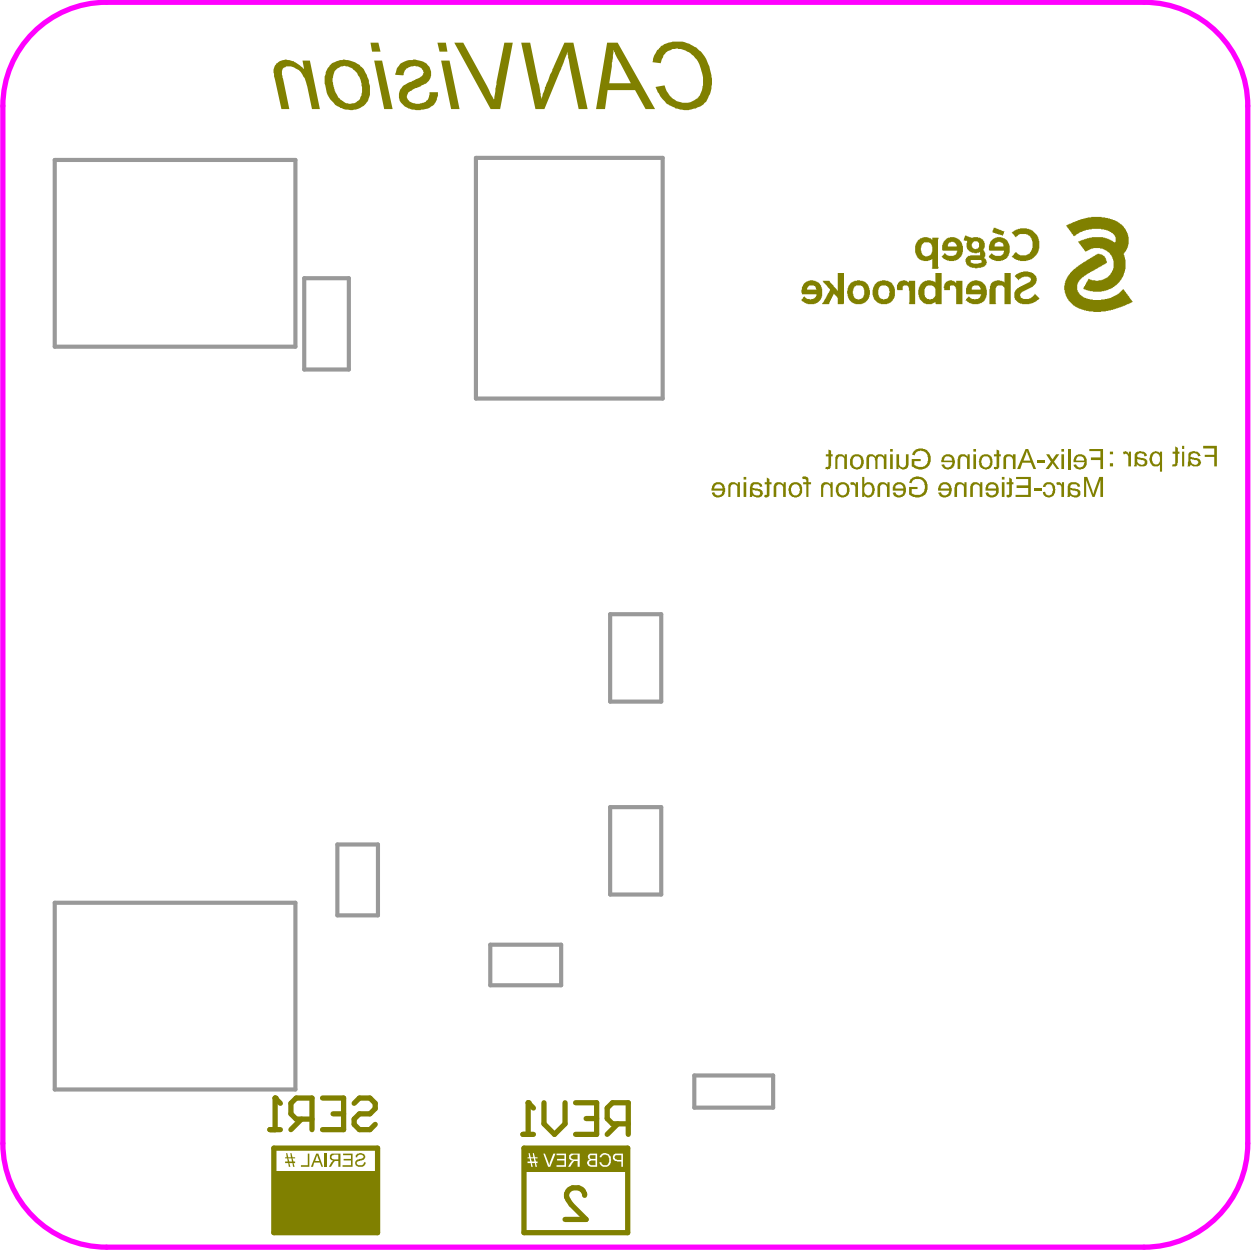
[picture p45: page 10]
