FelixAntoine0708/projet_Formule_SAE/H24/MATERIEL/PCB/PCB_V2_Final_/02 - PDF/PCB_MCP_Final_SCH REV 2.00.PDF

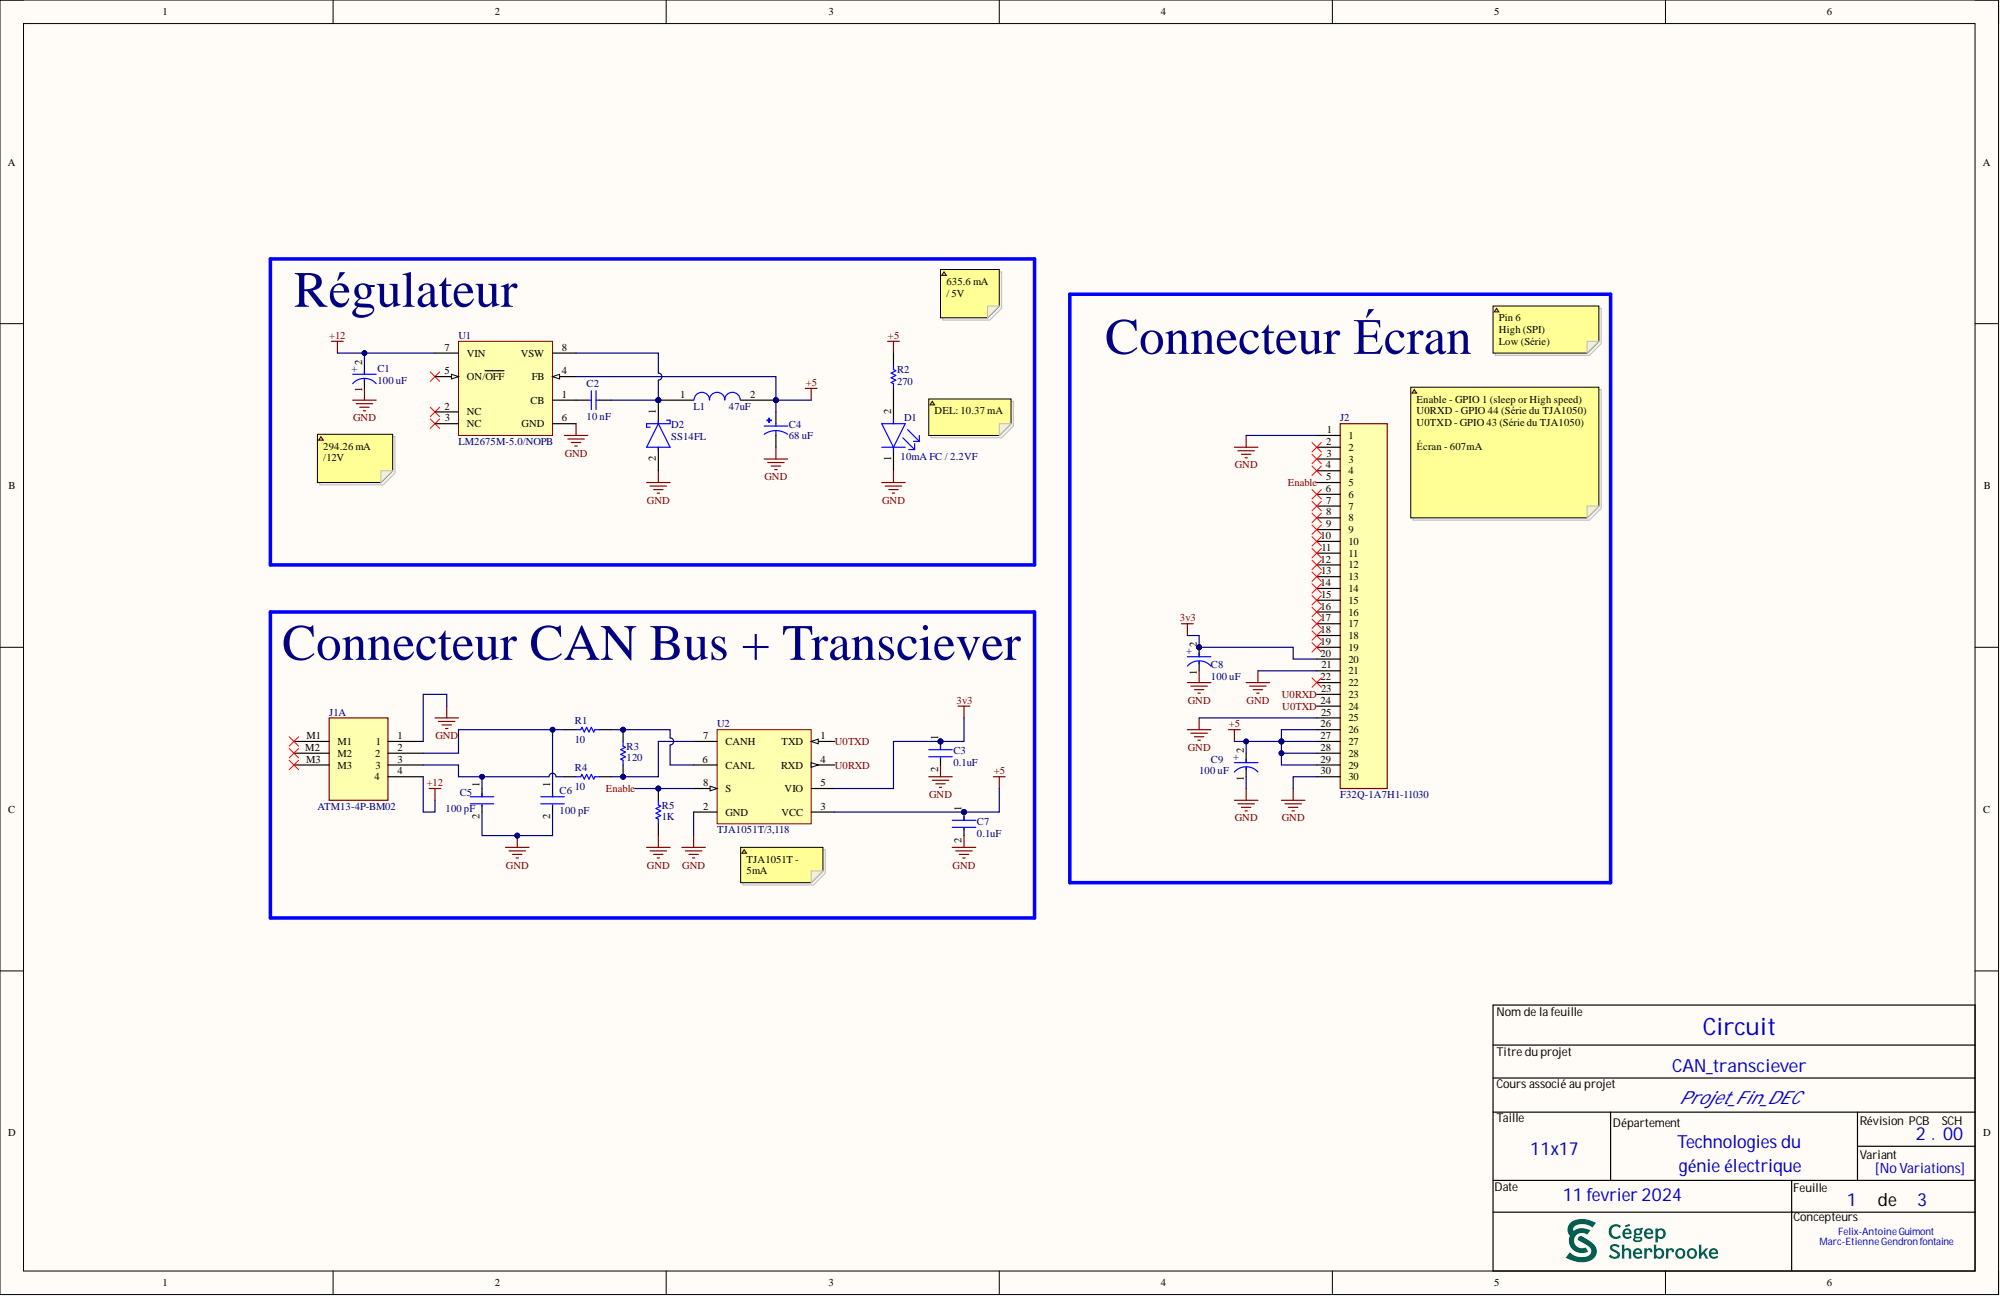
[picture p46: page 1]

Nom de la feui

D ate fevrier | Feui l l e d e

Concepteurs Felix -Antoin e Gu i mon t Marc-Etien n e Gen d ron fon ta i ne

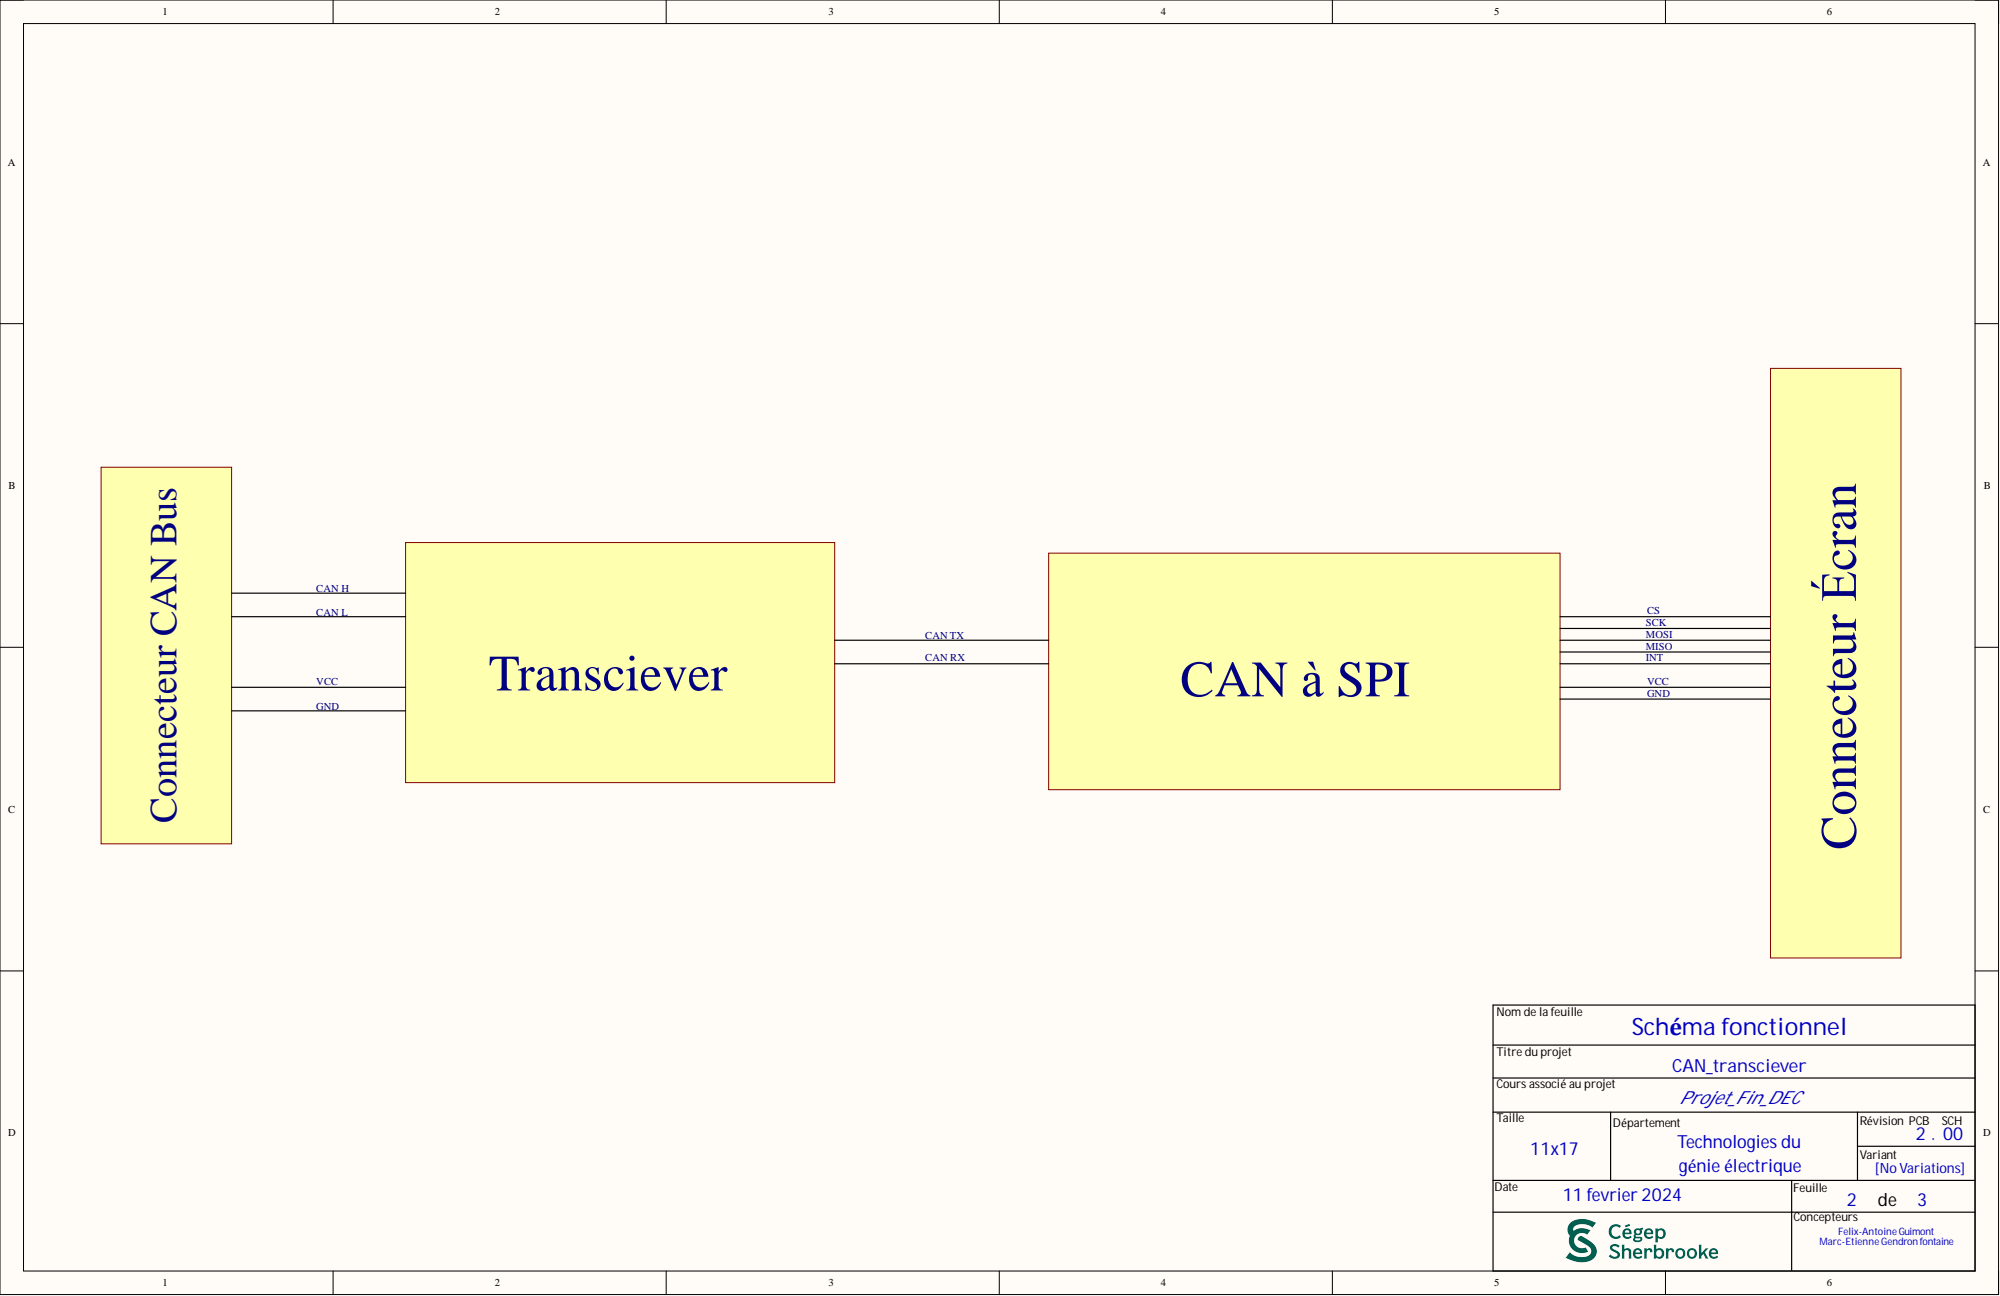
[picture p47: page 2]

Nom de la feuille

Cours associé au projet

Date 11 fevrier 2024 | Feuille 2 de 3

Felix-Antoine Guimont Marc-Etienne Gendron fontaine

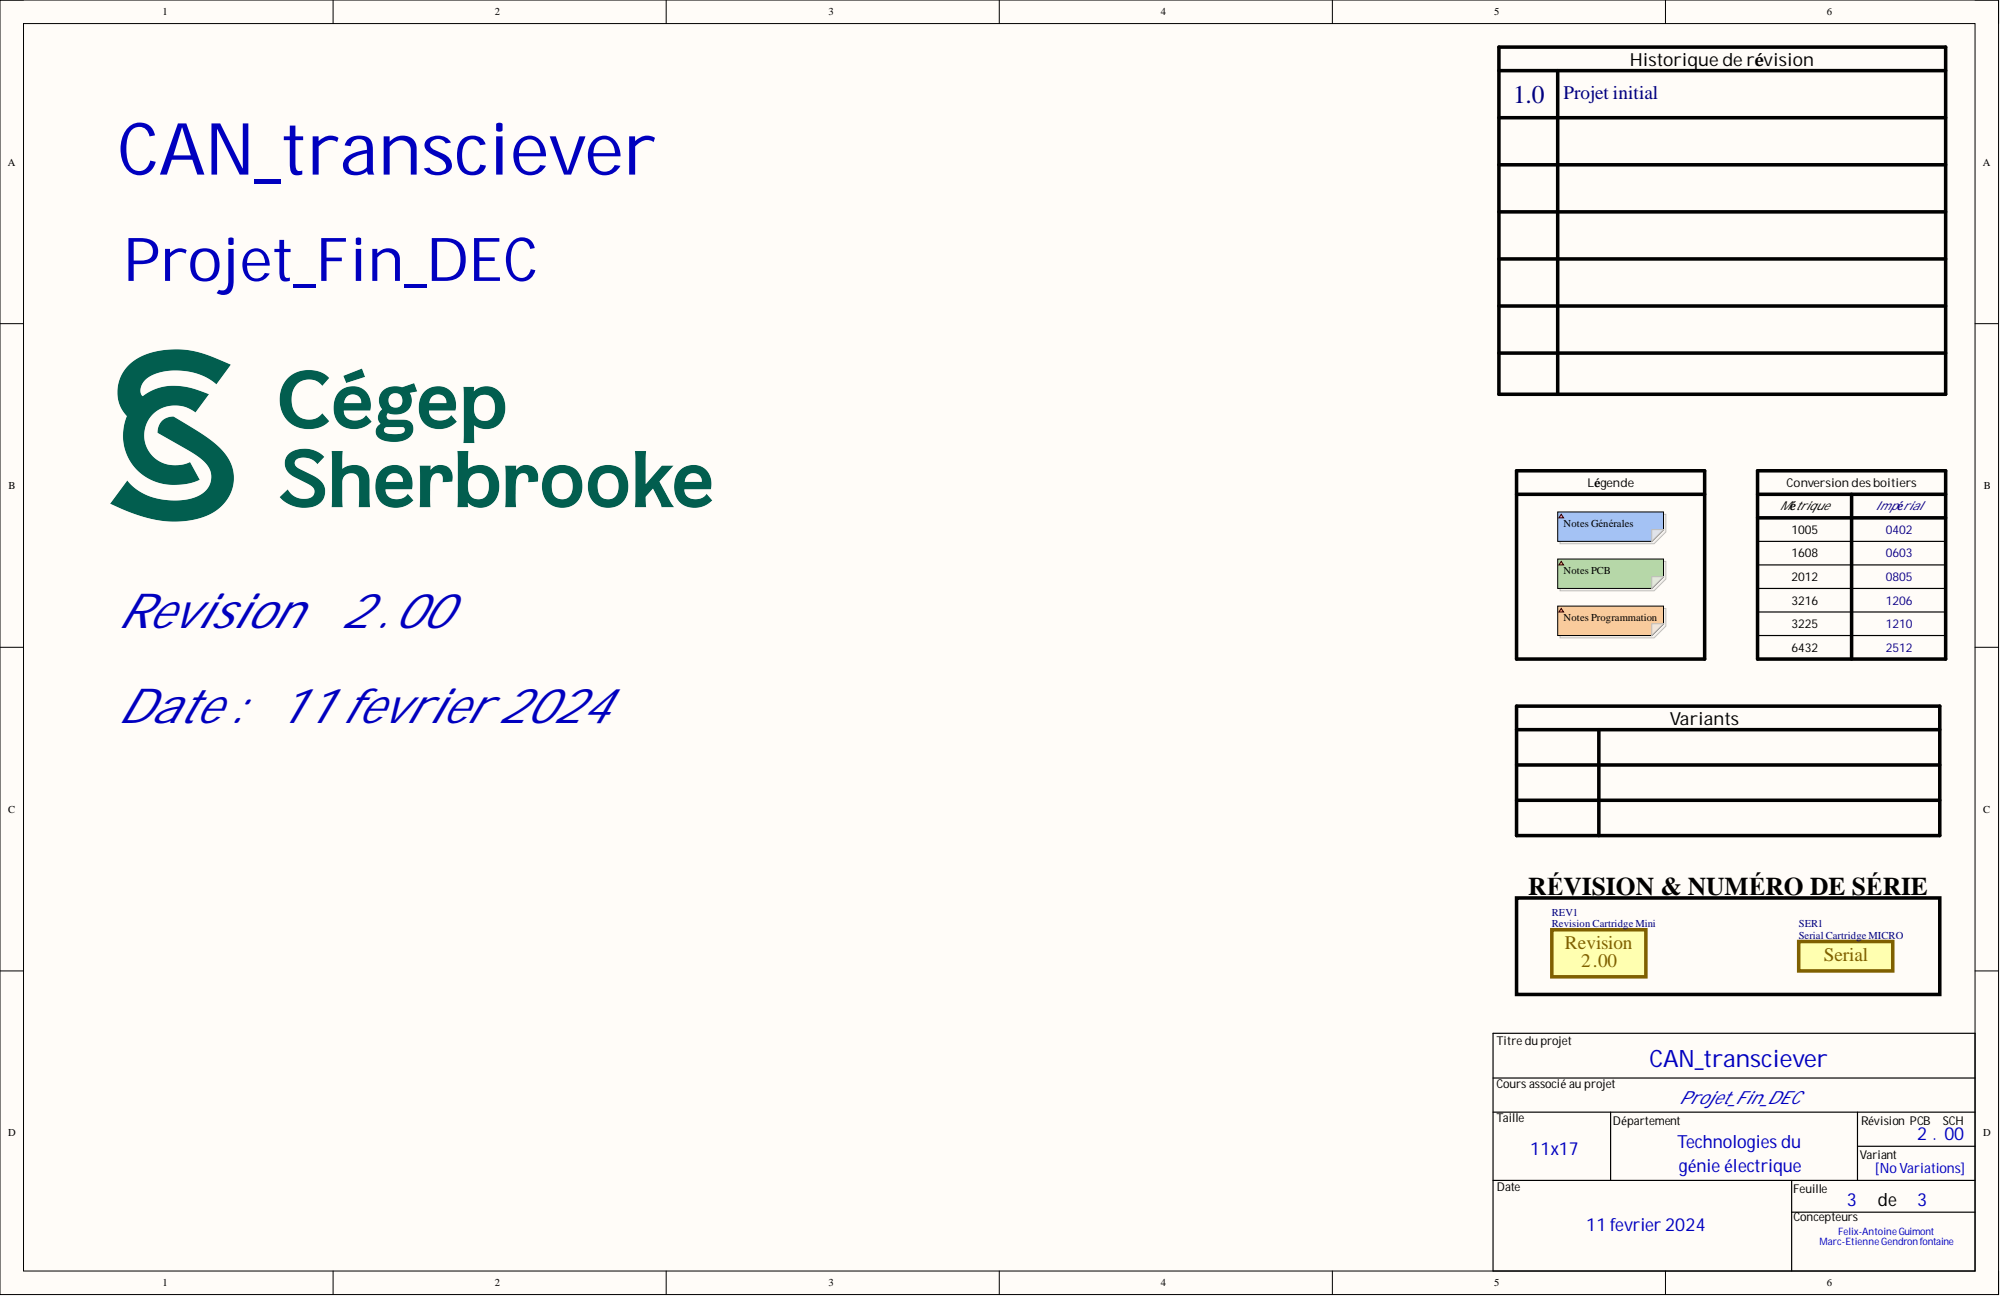
[picture p48: page 3]
