FelixAntoine0708/projet_Formule_SAE/(list of files, drawings)

Other design files:
H24/MATERIEL/PCB/Fichier_Altium_PCB_V2/PCB_MCP_Final.PrjPcb
H24/MATERIEL/PCB/Fichier_Altium_PCB_V2/PCB_MCP_Final.SCHLIB
H24/MATERIEL/PCB/Fichier_Altium_PCB_V2/TEMPLATE_Circuit.SchDoc
H24/MATERIEL/PCB/Fichier_Altium_PCB_V2/TEMPLATE_overview.SchDoc
H24/MATERIEL/PCB/Fichier_Altium_PCB_V2/TEMPLATE_PCB_2L.PcbDoc
H24/MATERIEL/PCB/Fichier_Altium_PCB_V2/TEMPLATE_Title.SchDoc
H24/MATERIEL/PCB/PCB_V2_Final_/04 - ASSEMBLY/PCB_MCP_Final_PCB ASCII REV 2.00.PcbDoc
