FelixAntoine0708/projet_Formule_SAE/H24/LOGICIEL/CODE_AFFICHAGE_ET_CAN_DÉSUET_/CAN_FCT.cpp

/*
Programme : CAN_FCT.cpp
Auteur :    Marc-Étienne Gendron-Fontaine
Date :      12 février 2024
Brief :     Ce fichier contient toutes les fonctions qui seront utiles au projet
            (lecture de la trame CAN, vérification de la trame CAN, affichage des informations, etc.)

Matérielle: ESP32-S3 (x2), TJA1050 (x2)
Encironement: Visual Studio Code V 1.86.2, Système d’exploitation : Linux x64 5.15.0-94-generic.
*/



#include <Arduino.h>
#include <ESP32-TWAI-CAN.hpp>
#include "ID_CAPT.h"
#include "CAN_FCT.h"


/*
Brief   : Affiche le premier octet de la section "data" de la trame CAN.
Param   : rxFrame soit la trame CAN.
Return  : Rien
*/
void affiche_data(CanFrame rxFrame)
{
    Serial.printf("%d \n", rxFrame.data[0]);
}


/*
Brief   : Vérifie si le premier octet, de la section "data" de la trame CAN,
          est bien un nombre. Si oui, on l'affiche. Sinon, on affiche un 
          message d'erreur.
Param   : rxFrame soit la trame CAN.
Return  : Rien
*/
bool verif_trame(CanFrame rxFrame)
{
  
  unsigned int crc_de_rxFrame;
  unsigned int crc_a_calculer;
  unsigned int temp;

  // Le CRC est calculé à partir de l'ensemble des champs transmis jusque-là c'est-à-dire le SOF, le champ d'arbitrage, le champ de commande et le champ de données MAX 83 BITS
  // LA TRAME CAN FAIT 108 BITS (64 BITS DANS CHAMPS DE DONNÉES EST PRIS POUR ACQUIS). LES CHAMPS ACK ET FIN DE TRAME FONT 9 BITS. DONC >> 9 APRÈS AVOIR FAIT UN MASKE.
  // LA VALEUR DU MASK EST 0x1FFFE00



  //crc_de_rxFrame = rxFrame;

  //temp = crc_de_rxFrame & MASK_CRC;

  //crc_a_calculer = temp >> 9;


  if(!(isAlpha(rxFrame.data[0])))
  {
    affiche_data(rxFrame);
    return true;
  }
  else
    Serial.printf("ERREUR!!!!!!!!!!!!!!\n");
}


/*
Brief   : Affiche la Température du liquide de refroidissement.
Param   : rxFrame soit la trame CAN.
Return  : Rien
*/
void coolant_temp(CanFrame rxFrame)
{
  Serial.printf("Température du liquide de refroidissement : ");
  verif_trame(rxFrame);
}

/*
Brief   : Affiche la Température interne de l’onduleur.
Param   : rxFrame soit la trame CAN.
Return  : Rien
*/
void drive_temp(CanFrame rxFrame)
{
  Serial.printf("Température interne de l’onduleur : ");
  verif_trame(rxFrame);
}



/*
Brief   : Affiche la Température interne du moteur.
Param   : rxFrame soit la trame CAN.
Return  : Rien
*/
void motor_temp(CanFrame rxFrame)
{
  Serial.printf("Température interne du moteur : ");
  verif_trame(rxFrame);
}

/*
Brief   : Affiche la Température interne de l’accumulateur.
Param   : rxFrame soit la trame CAN.
Return  : Rien
*/
void hv_temp(CanFrame rxFrame)
{
  Serial.printf("Température interne de l’accumulateur : ");
  verif_trame(rxFrame);
}

/*
Brief   : Affiche le Niveau de charge de l’accumulateur.
Param   : rxFrame soit la trame CAN.
Return  : Rien
*/
void hv_soc(CanFrame rxFrame)
{
  Serial.printf("Niveau de charge de l’accumulateur : ");
  verif_trame(rxFrame);
}


/*
Brief   : Affiche le Niveau de santé de l’accumulateur.
Param   : rxFrame soit la trame CAN.
Return  : Rien
*/
void hv_soh(CanFrame rxFrame)
{
  Serial.printf("Niveau de santé de l’accumulateur : ");
  verif_trame(rxFrame);
}

/*
Brief   : Affiche la Tension totale de l’accumulateur.
Param   : rxFrame soit la trame CAN.
Return  : Rien
*/
void hv_voltage(CanFrame rxFrame)
{
  Serial.printf("Tension totale de l’accumulateur : ");
  verif_trame(rxFrame);
}

/*
Brief   : Affiche le Niveau de charge de la batterie 12V.
Param   : rxFrame soit la trame CAN.
Return  : Rien
*/
void lv_soc(CanFrame rxFrame)
{
  Serial.printf("Niveau de charge de la batterie 12V : ");
  verif_trame(rxFrame);
}


/*
Brief   : Affiche la Tension de la batterie 12V.
Param   : rxFrame soit la trame CAN.
Return  : Rien
*/
void lv_voltage(CanFrame rxFrame)
{
  Serial.printf("Tension de la batterie 12V : ");
  verif_trame(rxFrame);
}

/*
Brief   : Affiche la Température de la batterie 12V.
Param   : rxFrame soit la trame CAN.
Return  : Rien
*/
void lv_temp(CanFrame rxFrame)
{
  Serial.printf("Température de la batterie 12V : ");
  verif_trame(rxFrame);
}



/*
Brief   : Lis le port série à chaque seconde. Si une trame CAN
          est reçue, on regarde l'ID et on appelle la fonction
          d'affichage correspondante.
Param   : rxFrame soit la trame CAN.
Return  : Rien
*/
void read_CAN(CanFrame rxFrame)
{
    // Si on reçoit une transmission, on regarde l’ID puis,
    // on affiche le bon message.
    if(ESP32Can.readFrame(rxFrame, 1000))
    {
        
        
      switch (rxFrame.identifier)
      {
        case COOLANT_TEMP:
          coolant_temp(rxFrame);
          break;
        case DRIVE_TEMP:
          drive_temp(rxFrame);
          break;
        case MOTOR_TEMP:
          motor_temp(rxFrame);
          break;
        case HV_TEMP:
          hv_temp(rxFrame);
          break;
        case HV_SOC:
          hv_soc(rxFrame);
          break;
        case HV_SOH:
          hv_soc(rxFrame);
          break;
        case HV_VOLTAGE:
          hv_voltage(rxFrame);
          break;
        case LV_SOC:
          lv_soc(rxFrame);
          break;
        case LV_VOLTAGE:
          lv_voltage(rxFrame);
          break;
        case LV_TEMP:
          lv_temp(rxFrame);
          break;
        default:
          break;
      }
              
    }
}


/*
Brief   : Envoie des trames CAN selon l’ID envoyée en paramètre.
Param   : id soit l'ID du capteur
Return  : Rien
*/
void send_CAN(int id)
{
  CanFrame txTrame;   // Création de la trame CAN qui servira pour la transmission.

  txTrame.identifier = id;
  txTrame.extd = 0;
  txTrame.data_length_code = 8;
  
  for(int i=0; i<8; i++)
    txTrame.data[i] = i+1;
  
  //txTrame.data[0] = 'C';

  ESP32Can.writeFrame(txTrame, 1000);   // Envoie de la trame à chaque seconde (par défaut).
}
