FelixAntoine0708/projet_Formule_SAE/H24/LOGICIEL/AFFICHAGE_SAE/AFFICHAGE_SAE_CAN_DESUET_/AFFICHAGE_SAE_CAN_V_0_0_1/AFFICHAGE_SAE_CAN_V_0_0_1Const.h

// File generated 2024-04-17 14:37:57
// Warning! This is a generated file, any manual changes will be
// lost during the next generation.

#define  IFONT_OFFSET     0
// object indexes into ImageControl
#define iStatictext9            0 // offset 0x0
#define iLeddigits5             1 // offset 0xE00
#define iiLeddigits5            2 // offset 0x6E00
#define iLeddigits6             3 // offset 0x15E00
#define iiLeddigits6            4 // offset 0x1C200
#define iLeddigits7             5 // offset 0x2C000
#define iiLeddigits7            6 // offset 0x30C00
#define iLeddigits8             7 // offset 0x3C800
#define iiLeddigits8            8 // offset 0x43000
#define iStatictext10           9 // offset 0x52E00
#define iStatictext11          10 // offset 0x54600
#define iStatictext12          11 // offset 0x55800
#define iStatictext13          12 // offset 0x56600
#define iWinbutton1            13 // offset 0x57400
#define iWinbutton2            14 // offset 0x5DE00
#define iWinbutton3            15 // offset 0x64800
#define iGauge1                16 // offset 0x6B400
#define iLeddigits1            17 // offset 0x2FDC00
#define iiLeddigits1           18 // offset 0x303000
#define iStatictext1           19 // offset 0x310000
#define iGauge2                20 // offset 0x312400
#define iLeddigits2            21 // offset 0x583600
#define iiLeddigits2           22 // offset 0x588A00
#define iStatictext2           23 // offset 0x595E00
#define iGauge3                24 // offset 0x598000
#define iLeddigits3            25 // offset 0x800E00
#define iiLeddigits3           26 // offset 0x806000
#define iStatictext3           27 // offset 0x812C00
#define iStatictext4           28 // offset 0x815600
#define iStatictext5           29 // offset 0x817000
#define iGauge4                30 // offset 0x817C00
#define iStatictext6           31 // offset 0xA3DE00
#define iAngularmeter1         32 // offset 0xA3F000
#define iStatictext7           33 // offset 0x1343200
#define iLeddigits4            34 // offset 0x1344000
#define iiLeddigits4           35 // offset 0x134AE00
#define iStatictext8           36 // offset 0x135BE00


static const bool inputs[] PROGMEM = { false, false, false, false, false, false, false, false, 
                  false, false, false, false, false, true, true, true, 
                  false, false, false, false, false, false, false, false, 
                  false, false, false, false, false, false, false, false, 
                  false, false, false, false, false} ;
