FelixAntoine0708/projet_Formule_SAE/H24/LOGICIEL/CODE_AFFICHAGE_ET_CAN_DÉSUET_/FCT_AFF.h

void setup_aff();
void setup_page_batterie();
void setup_page_accumulateur();
void setup_page_moteur_drive_coolant();
void affiche_page_batterie();
void affiche_page_accumulateur();
void affiche_page_moteur_drive_coolant();
void update_page_batterie();
