FelixAntoine0708/projet_Formule_SAE/H24/LOGICIEL/AFFICHAGE_SAE/DEMO_AFFICHAGE_POUR_UNI/AFFICHAGE_SAE_V2/AFFICHAGE_SAE_V2.ino

//
// NB! This is a file generated from the .4Dino file, changes will be lost
//     the next time the .4Dino file is built
//
/*
Programme : AFFICHAGE_SAE_V2.4Dino
Auteur :    Marc-Étienne Gendron-Fontaine
Date :      7 mars 2024
Brief :     Ce fichier contient la deuxième version de ce que pourrait être l'affichage. Les données sont fictives.

Matérielle: ESP32-S3R8 (dans l'écran), écran gen4_ESP32_70CT
Encironement: Workshop 4 V4.9.0.7,
Système d'exploitation: Windows 10 V22H2.

*/




#include "gfx4desp32_gen4_ESP32_70CT.h"

gfx4desp32_gen4_ESP32_70CT gfx = gfx4desp32_gen4_ESP32_70CT();

#include "AFFICHAGE_SAE_V2Const.h"    // Note. This file will not be created if there are no generated graphics

#include "CONST_AFF.h"
#include "CONST_AFF_BAT.h"
#include "CONST_AFF_MDC.h"
#include "CONST_AFF_ACC.h"



// PROTOTYPE DES FCT
void init_btn();
void init_light();
void clear();
void nom_batterie();
void nom_accumulateur();
void nom_mott();
void donne_batterie();
void donne_acc();
void donne_mdc();
void Batterie();
void Accumulateur();
void Mott();
void touch_btn();
void hello_1();
void hello_2();





void setup()
{
  gfx.begin();
  gfx.Cls();
  gfx.ScrollEnable(false);
  gfx.BacklightOn(true);
  gfx.Orientation(LANDSCAPE);
  gfx.SmoothScrollSpeed(5);
  gfx.TextColor(WHITE, BLACK); gfx.Font(3);  gfx.TextSize(2);
  gfx.Open4dGFX("AFFICHAGE_SAE_V2"); // Opens DAT and GCI files for read using filename without extension.
  gfx.touch_Set(TOUCH_ENABLE);                // Global touch enabled

  init_btn();        // Initialise les BTN
  init_light();        // Initialise le BTN LIGHT
  Accumulateur();    // Affiche la page Accumulateur


} // end Setup **do not alter, remove or duplicate this line**

void loop()
{

    // Regarde si un BTN est pressés
   touch_btn();





    // !!!!!!!!!!!!!!!!!!!!!!!NE PAS ENLEVER LE CODE JUSTE EN DESSOUS!!!!!!!!!!!!!!!!!!!!

  // put your main code here, to run repeatedly:
  /*int itouched, val ;
  if(gfx.touch_Update())
  {
    itouched = gfx.imageTouched() ;
    switch (itouched)
    {                                                         // start touched selection **do not alter, remove or duplicate this line**
      // case statements for Knobs and Sliders go here
      default :                                               // end touched selection **do not alter, remove or duplicate this line**
        int button = gfx.ImageTouchedAuto();    // use default for keyboards and buttons
        val = gfx.getImageValue(button);
        switch (button)
        {                                                     // start button selection **do not alter, remove or duplicate this line**
          // case, one for each button or keyboard, default should end up as -1
        }                                                     // end button selection **do not alter, remove or duplicate this line**
    }
  }*/
}



/*
Brief   : Initialise les BTN pour changer de page.
Param   : Rien
Return  : Rien
*/
void init_btn()
{
  gfx.RectangleFilled(0, 415, 800, 500, YELLOW);    // Fait une bande JAUNE


    /*
        Crée les BTN avec les paramètre suivant (en ordre) :

        ID du BTN
        Position en X de l'extrémité gauche du BTN
        Position en Y du côté suppérieur du BTN
        La largeur du BTN
        La hauteur du BTN
        La couleur de fond
        Le texte à l'intérieur
        La police de caractère
        La couleur du text
    */
  gfx.Buttonx(BTN_1, X_BTN_BATTERIE, Y_BTN, LONG_BTN_X, HAUT_BTN, WHITE, BATTERIE, 2, BLACK);
  gfx.Buttonx(BTN_2, X_BTN_ACCUMULATEUR, Y_BTN, LONG_BTN_X, HAUT_BTN, WHITE, ACCUMULATEUR, 2, BLACK);
  gfx.Buttonx(BTN_3, X_BTN_MOTEUR_DRIVE_COOLANT, Y_BTN, LONG_BTN_X, HAUT_BTN, WHITE, MOTEUR_DRIVE_COOLANT, 2, BLACK);

}



/*
Brief   : Initialise le BTN LIGHT servant à éteindre la back light.
Param   : Rien
Return  : Rien
*/
void init_light()
{
  // Un BTN de 100x100 pour éteindre la back light
  gfx.Buttonx(BTN_4, 700, 0, 100, 100, WHITE, "LIGHT", 2, BLACK);
}


/*
Brief   : Efface la partie au dessus des BTN
Param   : Rien
Return  : Rien
*/
void clear()
{
   gfx.RectangleFilled(0, 0, 800, 415, BLACK);    // Dessine un rectangle noir pour "effacer" l'écran

   init_light();    // Remet le BTN LIGHT
}



/*
Brief   : Affiche le nom de la page Batterie
Param   : Rien
Return  : Rien
*/
void nom_batterie()
{
    gfx.MoveTo(POSX_NOM_PAGE, POSY_NOM_PAGE);
    gfx.print(EFFACE);
    gfx.MoveTo(POSX_NOM_PAGE, POSY_NOM_PAGE);
    gfx.print(BATTERIE);
}



/*
Brief   : Affiche le nom de la page Accumulateur
Param   : Rien
Return  : Rien
*/
void nom_accumulateur()
{
    gfx.MoveTo(POSX_NOM_PAGE, POSY_NOM_PAGE);
    gfx.print(EFFACE);
    gfx.MoveTo(POSX_NOM_PAGE, POSY_NOM_PAGE);
    gfx.print(ACCUMULATEUR);
}


/*
Brief   : Affiche le nom de la page MOTEUR_DRIVE_COOLANT
Param   : Rien
Return  : Rien
*/
void nom_mott()
{
    gfx.MoveTo(POSX_NOM_PAGE, POSY_NOM_PAGE);
    gfx.print(EFFACE);
    gfx.MoveTo(POSX_NOM_PAGE, POSY_NOM_PAGE);
    gfx.print(MOTEUR_DRIVE_COOLANT);
}



/*
Brief   : Affiche les données de la page batterie
Param   : Rien
Return  : Rien
*/
void donne_batterie()
{
   // NOM TEMPERATURE
   gfx.MoveTo(POSX_NOM_TEMP_BAT, POSY_NOM_DON_BAT);
   gfx.print(TEMP);
   gfx.print(55);
   gfx.print(" C");

   // BAR TEMPERATURE
   gfx.RectangleFilled(POSX_BAR_TEMP_BAT, POSY_1_R_TEMP_BAT, LARG_BAR_TEMP_BAT, POSY_2_R_TEMP_BAT, RED);
   gfx.RectangleFilled(POSX_BAR_TEMP_BAT, POSY_1_J_TEMP_BAT, LARG_BAR_TEMP_BAT, POSY_2_J_TEMP_BAT, YELLOW);
   gfx.RectangleFilled(POSX_BAR_TEMP_BAT, POSY_1_V_TEMP_BAT, LARG_BAR_TEMP_BAT, POSY_2_V_TEMP_BAT, GREEN);

   // BAR CHARGE
   gfx.RectangleFilled(POSX_BAR_CHAR_BAT, POSY_1_V_CHAR_BAT, LARGE_BAR_CHAR_BAT, POSY_2_V_CHAR_BAT, GREEN);
   gfx.RectangleFilled(POSX_BAR_CHAR_BAT, POSY_1_J_CHAR_BAT, LARGE_BAR_CHAR_BAT, POSY_2_J_CHAR_BAT, YELLOW);
   gfx.RectangleFilled(POSX_BAR_CHAR_BAT, POSY_1_R_CHAR_BAT, LARGE_BAR_CHAR_BAT, POSY_2_R_CHAR_BAT, RED);

   // NOM CHARGE
   gfx.MoveTo(POSX_NOM_CHAR_BAT, POSY_NOM_DON_BAT);
   gfx.print(NIV_CHARGE);
   gfx.print(85);
   gfx.print("%");

   // SECTION TENSION
   gfx.MoveTo(POSX_NOM_TENS_BAT, POSY_NOM_TENS_BAT);
   gfx.print(VOLT);
   gfx.print(12);
   gfx.print("V");
}



/*
Brief   : Affiche les données de la page Accumulateur
Param   : Rien
Return  : Rien
*/
void donne_acc()
{
  // NOM TEMPERATURE
  gfx.MoveTo(POSX_NOM_TEMP_ACC, POSY_NOM_DON_ACC);
  gfx.print(TEMP);
  gfx.print(1000);
  gfx.print(" C");

  // BAR TEMPERATURE
  gfx.RectangleFilled(POSX_BAR_TEMP_ACC, POSY_1_R_TEMP_ACC, LARG_BAR_TEMP_ACC, POSY_2_R_TEMP_ACC, RED);
  gfx.RectangleFilled(POSX_BAR_TEMP_ACC, POSY_1_J_TEMP_ACC, LARG_BAR_TEMP_ACC, POSY_2_J_TEMP_ACC, YELLOW);
  gfx.RectangleFilled(POSX_BAR_TEMP_ACC, POSY_1_V_TEMP_ACC, LARG_BAR_TEMP_ACC, POSY_2_V_TEMP_ACC, GREEN);

  // NOM CHARGE
  gfx.MoveTo(POSX_NOM_CHAR_ACC, POSY_NOM_DON_ACC);
  gfx.print(NIV_CHARGE);
  gfx.print(95);
  gfx.print("%");

  // BAR CHARGE
  gfx.RectangleFilled(POSX_BAR_CHAR_ACC, POSY_1_V_CHAR_ACC, LARGE_BAR_CHAR_ACC, POSY_2_V_CHAR_ACC, GREEN);
  gfx.RectangleFilled(POSX_BAR_CHAR_ACC, POSY_1_J_CHAR_ACC, LARGE_BAR_CHAR_ACC, POSY_2_J_CHAR_ACC, YELLOW);
  gfx.RectangleFilled(POSX_BAR_CHAR_ACC, POSY_1_R_CHAR_ACC, LARGE_BAR_CHAR_ACC, POSY_2_R_CHAR_ACC, RED);

  // SECTION SANTE
  gfx.MoveTo(POSX_NOM_SANTE_ACC, POSY_NOM_SANTE_ACC);
  gfx.print(SANTE);
  gfx.print("BONNE");


  // SECTION TENSION
  gfx.MoveTo(POSX_NOM_TENS_ACC, POSY_NOM_TENS_ACC);
  gfx.print(VOLT);
  gfx.print(12);
  gfx.print("V");

}



/*
Brief   : Affiche les données de la page MOTEUR_DRIVE_COOLANT
Param   : Rien
Return  : Rien
*/
void donne_mdc()
{
   // SECTION MOTTEUR
   gfx.MoveTo(POSX_NOM_MOT, POSY_NOM_DON_MDC);
   gfx.print(NOM_TEMP_MOT);
   gfx.print(60);
   gfx.print(" C");

   // MAR MOTTEUR
   gfx.RectangleFilled(POSX_TEMP_MOT, POSY_1_R_MOT, LARG_BAR_MOT, POSY_2_R_MOT, RED);
   gfx.RectangleFilled(POSX_TEMP_MOT, POSY_1_J_MOT, LARG_BAR_MOT, POSY_2_J_MOT, YELLOW);
   gfx.RectangleFilled(POSX_TEMP_MOT, POSY_1_V_MOT, LARG_BAR_MOT, POSY_2_V_MOT, GREEN);

   // SECTION DRIVE
   gfx.MoveTo(POSX_NOM_DRIV, POSY_NOM_DON_MDC);
   gfx.print(NOM_TEMP_DRIV);
   gfx.print(50);
   gfx.print(" C");

   // BAR DRIVE
   gfx.RectangleFilled(POSX_TEMP_DRIV, POSY_1_R_DRIV, LARG_BAR_DRIV, POSY_2_R_DRIV, RED);
   gfx.RectangleFilled(POSX_TEMP_DRIV, POSY_1_J_DRIV, LARG_BAR_DRIV, POSY_2_J_DRIV, YELLOW);
   gfx.RectangleFilled(POSX_TEMP_DRIV, POSY_1_V_DRIV, LARG_BAR_DRIV, POSY_2_V_DRIV, GREEN);

   // SECTION COOLANT
   gfx.MoveTo(POSX_NOM_COOL, POSY_NOM_DON_MDC);
   gfx.print(NOM_TEMP_COOL);
   gfx.print(45);
   gfx.print(" C");

    // BAR COOL
   gfx.RectangleFilled(POSX_TEMP_COOL, POSY_1_R_COOL, LARG_BAR_COOL, POSY_2_R_COOL, RED);
   gfx.RectangleFilled(POSX_TEMP_COOL, POSY_1_J_COOL, LARG_BAR_COOL, POSY_2_J_COOL, YELLOW);
   gfx.RectangleFilled(POSX_TEMP_COOL, POSY_1_V_COOL, LARG_BAR_COOL, POSY_2_V_COOL, GREEN);
}


/*
Brief   : Affiche la page Batterie
Param   : Rien
Return  : Rien
*/
void Batterie()
{
    clear();
    nom_batterie();
    donne_batterie();
    gfx.ButtonActive(BTN_1, false);
    gfx.ButtonActive(BTN_2, true);
    gfx.ButtonActive(BTN_3, true);
}


/*
Brief   : Affiche la page Accumulateur
Param   : Rien
Return  : Rien
*/
void Accumulateur()
{
   clear();
   nom_accumulateur();
   donne_acc();
   gfx.ButtonActive(BTN_1, true);
   gfx.ButtonActive(BTN_2, false);
   gfx.ButtonActive(BTN_3, true);
}


/*
Brief   : Affiche la page MOTEUR_DRIVE_COOLANT
Param   : Rien
Return  : Rien
*/
void Mott()
{
   clear();
   nom_mott();
   donne_mdc();
   gfx.ButtonActive(BTN_1, true);
   gfx.ButtonActive(BTN_2, true);
   gfx.ButtonActive(BTN_3, false);
}


/*
Brief   : Regarde quel BTN à été pressés et affiche la page en conséquance.
Param   : Rien
Return  : Rien
*/
void touch_btn()
{
  int btnXtouch;    // Pour garder le ID du BTN

    // Si on touche l'écran, on allume la back light
  if(gfx.touch_GetX()<=700)
     gfx.BacklightOn(true);

    // Prend le ID du BTN pressé
  btnXtouch = gfx.CheckButtons();

    // Affiche la bonne page selon le BTN pressé ou,
    // étein la back light.
  if(btnXtouch == BTN_1)
    Batterie();
  else if(btnXtouch == BTN_2)
    Accumulateur();
  else if(btnXtouch == BTN_3)
    Mott();
  else if(btnXtouch == BTN_4)
     gfx.BacklightOn(false);
}


// -------------------------------- MESSAGE POUR LE DEBUG ------------------------------------


/*
Brief   : Affiche HELLO_1 sur l'écran
Param   : Rien
Return  : Rien
*/
void hello_1()
{
    gfx.MoveTo(150, 150);
    gfx.print(EFFACE);
    gfx.MoveTo(150, 150);
    gfx.print("HELLO_1!!!!!");
}


/*
Brief   : Affiche HELLO_2 sur l'écran
Param   : Rien
Return  : Rien
*/
void hello_2()
{
    gfx.MoveTo(150, 150);
    gfx.print(EFFACE);
    gfx.MoveTo(150, 150);
    gfx.print("HELLO_2!!!!!");
}
