FelixAntoine0708/projet_Formule_SAE/H24/LOGICIEL/AFFICHAGE_SAE/DEMO_AFFICHAGE_POUR_UNI/Code_Affichage_SAE_V1_FA_Guimont_MODIF/Code_project/Code_projectConst.h

// File generated 2024-03-18 11:05:07
// Warning! This is a generated file, any manual changes will be
// lost during the next generation.

#define  IFONT_OFFSET     0
// object indexes into ImageControl
#define iAngularmeter1          0 // offset 0x0
#define iAngularmeter2          1 // offset 0xB02800
#define iAngularmeter3          2 // offset 0x1643A00
#define iStatictext1            3 // offset 0x2184C00
#define iStatictext2            4 // offset 0x2188000
#define iStatictext3            5 // offset 0x218A400
#define iStatictext6            6 // offset 0x218D400
#define iWinbutton1             7 // offset 0x218FA00
#define iWinbutton2             8 // offset 0x2193C00
#define iStatictext7            9 // offset 0x2197E00
#define iWinbutton4            10 // offset 0x2199000
#define iWinbutton5            11 // offset 0x219D200
#define iAngularmeter4         12 // offset 0x21A1400
#define iLeddigits1            13 // offset 0x2AA5600
#define iiLeddigits1           14 // offset 0x2AA9600
#define iMeter1                15 // offset 0x2AB3600
#define iStatictext4           16 // offset 0x2F8E400
#define iStatictext5           17 // offset 0x2F8F600
#define iStatictext8           18 // offset 0x2F90400
#define iStatictext10          19 // offset 0x2F91C00
#define iWinbutton3            20 // offset 0x2F93000
#define iWinbutton6            21 // offset 0x2F9B400
#define iAngularmeter5         22 // offset 0x2F9F600
#define iMeter2                23 // offset 0x38A3800
#define iTank1                 24 // offset 0x3EB9800
#define iLeddigits2            25 // offset 0x40BF600
#define iiLeddigits2           26 // offset 0x40C3000
#define iStatictext9           27 // offset 0x40CF000
#define iStatictext11          28 // offset 0x40D0800
#define iStatictext12          29 // offset 0x40D1A00
#define iStatictext13          30 // offset 0x40D2800


static const bool inputs[] PROGMEM = { false, false, false, false, false, false, false, true, 
                  true, false, true, true, false, false, false, false, 
                  false, false, false, false, true, true, false, false, 
                  false, false, false, false, false, false, false} ;
