FelixAntoine0708/projet_Formule_SAE/H24/LOGICIEL/CODE_DE_TEST/TEST_GFX_CAN/ID_CAPT.h

/*
Programme : ID_CAPT.h
Auteur :    Marc-Étienne Gendron-Fontaine
Date :      12 février 2024
Brief :     Ce fichier d'entête contient tous les ID des capteurs sous forme de constante.

Mat�rielle: ESP32-S3 (x2), TJA1050 (x2)
Encironement: Workshop 4 V4.9.0.7,
Syst�me d�exploitation�: Windows 10 V22H2.
*/



// ID CAPTEUR
#define COOLANT_TEMP  0xA0  // Température du liquide de refroidissement
#define DRIVE_TEMP    0xA1  // Température interne de l’onduleur
#define MOTOR_TEMP    0xA2  // Température interne du moteur
#define HV_TEMP       0xA3  // Température interne de l’accumulateur
#define HV_SOC        0xA4  // Niveau de charge de l’accumulateur
#define HV_SOH        0xA5  // Niveau de santé de l’accumulateur
#define HV_VOLTAGE    0xA6  // Tension totale de l’accumulateur
#define LV_SOC        0xA7  // Niveau de charge de la batterie 12V
#define LV_VOLTAGE    0xA8  // Tension de la batterie 12V
#define LV_TEMP       0xA9  // Température de la batterie 12V
