FelixAntoine0708/projet_Formule_SAE/H24/LOGICIEL/AFFICHAGE_SAE/DEMO_AFFICHAGE_POUR_UNI/AFFICHAGE_SAE_V1_ME_Gendron-Fontaine/AFFICHAGE_SAE_V1Const.h

// File generated 2024-03-01 11:16:55
// Warning! This is a generated file, any manual changes will be
// lost during the next generation.

#define  IFONT_OFFSET     0
// object indexes into ImageControl
#define iThermometer1           0 // offset 0x0
#define iGauge1                 1 // offset 0x5F1C00
#define iStatictext1            2 // offset 0xA5E800
#define iStatictext2            3 // offset 0xA60800
#define iLeddigits1             4 // offset 0xA65E00
#define iiLeddigits1            5 // offset 0xA69C00
#define iStatictext3            6 // offset 0xA73400
#define iStatictext4            7 // offset 0xA76400
#define i4Dbutton1              8 // offset 0xA7BC00
#define i4Dbutton2              9 // offset 0xA7E200
#define i4Dbutton3             10 // offset 0xA80800
#define iStatictext14          11 // offset 0xA82E00
#define iStatictext15          12 // offset 0xA84000
#define iStatictext16          13 // offset 0xA85C00
#define iStatictext5           14 // offset 0xA88A00
#define iThermometer2          15 // offset 0xA8BE00
#define iGauge2                16 // offset 0xE19A00
#define iStatictext6           17 // offset 0x125C600
#define iAngularmeter1         18 // offset 0x125E000
#define iStatictext7           19 // offset 0x1B62200
#define iLeddigits2            20 // offset 0x1B63800
#define iiLeddigits2           21 // offset 0x1B69C00
#define iStatictext8           22 // offset 0x1B79A00
#define iStatictext9           23 // offset 0x1B7B800
#define iStatictext17          24 // offset 0x1B7C800
#define i4Dbutton4             25 // offset 0x1B7DA00
#define iStatictext18          26 // offset 0x1B80000
#define i4Dbutton5             27 // offset 0x1B81C00
#define iStatictext19          28 // offset 0x1B84200
#define i4Dbutton6             29 // offset 0x1B87000
#define iStatictext10          30 // offset 0x1B89600
#define iThermometer3          31 // offset 0x1B8EC00
#define iStatictext11          32 // offset 0x1F61600
#define iThermometer4          33 // offset 0x1F63200
#define iStatictext12          34 // offset 0x22F0E00
#define iThermometer5          35 // offset 0x22F2200
#define iStatictext13          36 // offset 0x267FE00
#define iStatictext20          37 // offset 0x2681E00
#define iStatictext21          38 // offset 0x2683000
#define iStatictext22          39 // offset 0x2684C00
#define i4Dbutton7             40 // offset 0x2687A00
#define i4Dbutton8             41 // offset 0x268A000
#define i4Dbutton9             42 // offset 0x268C600


static const bool inputs[] PROGMEM = { false, false, false, false, false, false, false, false, 
                  true, true, true, false, false, false, false, false, 
                  false, false, false, false, false, false, false, false, 
                  false, true, false, true, false, true, false, false, 
                  false, false, false, false, false, false, false, false, 
                  true, true, true} ;
