FelixAntoine0708/projet_Formule_SAE/(commit log)

2023-12-06 test de décodeur (il faut le tester)
2023-12-06 Le code est le code d'envoie avec un ESP32-C3
2023-12-06 Code du ESP32 receveur
2023-12-06 M-É ESP32 Slave SPI
2023-12-06 code OG de Master SPI
2023-12-06 M-É Modif code Master
    ajoute de décoder des caractères
2023-12-06 M-É Modif affiche si reçu par ESP32
2023-12-07 Updated PI_MASTER_AFF_BTN.py
    change le temps et l'état du bouton pour avoir une meilleur rapidité d’exécution et de mieux voir la modification sur la pression du bouton.
2023-12-15 Code final du prototype sur le Raspberry Pi
2023-12-20 Tout les codes avec les README.txt
2023-12-21 Cahier des charges du projet
2024-02-02 Dossier de Session
2024-02-02 Code d'envoie de l'équipe CAN Bus
2024-02-02 Code d'affichage de notre équipe
2024-02-09 Pour être sure de ne pas le perdre
    [NoName1.cfg]
2024-02-10 Code de test de l'affichage uLCD-32PT
    Je dois demander a Félix comment il fait de beau readme.md parce que les miens sont bof.
    [NoName1.cfg]
2024-02-16 Delete H24/TEST_AFF_PICASO directory
    J'ai oublié de le supprimer...
    [NoName1.cfg]
2024-02-16 Delete H24/CODE_TEST_AFFICHAGE_PICASO directory
    J'ai fais du ménage
    [NoName1.cfg]
2024-02-16 Meilleur structure
    [NoName1.cfg]
2024-02-16 J'uste pour avoir un backup de mon code
    Il n'est pas encore finit
2024-02-16 J'ai bien mis les fct du CAN dans CAN_FCT.cpp
2024-02-19 Pour garder le code de l'affichage V1
2024-02-22 PCB en PDF
    dans ce PDF, il y a un schéma bloc, le schématique et le layout du PCB frontal
2024-02-23 Create TEST_TEST_TEST.txt
    Ceci est un TEST de Commit de Github Deskop
2024-02-23 "Supression" des fichiers contennant les fonctions
    Benoît m'a demandé des les enlever pour tester la compilation. T'inquiète, je les ai sur mon ordie et sur une clé USB.
2024-02-24 Ajout du dossier CODE_AFFICHAGE_ET_CAN. Le reste en description :p
    * Modification de H24/README.md pour ajouter le dossier CODE_AFFICHAGE_ET_CAN
    * Ajout d'un README.md dans le dossier CODE_AFFICHAGE_ET_CAN pour clarifier le contenu de chaque fichier.
2024-02-26 Un code pour tester les BTN !
    Encore quelque erreur à corriger!
    [AFFICHAGE_SAE_V1.ino]
2024-02-26 Changement des BTN
2024-02-27 Juste la réponse de 4D Systems
    Pour ne pas aller le chercher dans mon couriel à chaque fois. C'est un fichier temporaire.
2024-02-27 Ajout du code des BTN pour changer de page
2024-02-28 Ajout de commantaire et des briefs
2024-02-28 Fichier STEP du PCB
2024-02-28 PDF final du PCB
2024-02-28 Tout les partie du Boitier 1er version
    [Boitier_V1.3mf, Devant_V1.3mf, Porte_V1.3mf]
2024-02-28 Fichier 3mf et STL du boitier
    [Boitier_V1.3mf, Boitier_V1.stl, Devant_V1.3mf, Devant_V1.stl, Porte_V1.3mf, Porte_V1.stl]
2024-02-28 PDF de piece
2024-02-28 PDB de piece
2024-02-28 Restructuration du Git
    [Boitier_V1.3mf, Boitier_V1.stl, Devant_V1.3mf, Devant_V1.stl, NoName1.cfg, Porte_V1.3mf, Porte_V1.stl]
2024-02-28 J'ai refais les README.md
2024-02-28 Create INSTRUCTION_POUR_FAIRE_AFFICHAGE.odt
    Juste des instructions pour faire un affichage. Il faut des captures d'écran
2024-02-28 Correction des fautes d'orthographe
2024-03-01 Suppression de deux fichiers non-importants
2024-03-01 Fichier PCB Altium
    [PCB_MCP2515.PrjPcb, PCB_MCP_Final.PrjPcb, PCB_MCP_Final.SCHLIB, TEMPLATE_Circuit.SchDoc, TEMPLATE_PCB_2L.PcbDoc, TEMPLATE_Title.SchDoc, TEMPLATE_overview.SchDoc]
2024-03-01 Fichier de fabrication
    [PCB_MCP_Final.PrjPcb, PCB_MCP_Final.SCHLIB, PCB_MCP_Final_BOM REV 1.00.xlsx, PCB_MCP_Final_PCB ASCII REV 1.00.PcbDoc, PCB_MCP_Final_PCB PNP XY REV 1.00.csv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]
2024-03-02 Create GFX4dESP32-arduino-esp32-v3.zip
    Pour avoir une copie de la librairie GFX pour l'écran 70CT
2024-03-02 Ajout de code Affichage
2024-03-05 Juste pour voir si on peut séparer les fcts d'affichages dans d'autre fichier
2024-03-06 J'ai commencer les commantaires
2024-03-06 J'ai mis les commantaire
    Il ne reste plus qu'à corriger les fautes
    [CONST_AFF.h, FCT_AFF.cpp]
2024-03-07 Correction des fautes d'orthographe.
    [CONST_AFF.h, FCT_AFF.cpp, FCT_AFF.h]
2024-03-08 Une deuxième version de l'affichage
2024-03-09 Finalisation de la page batterie
2024-03-10 Correction d'un bogue et début de la page trois
    J'ai mal à la tête!!!!!
    [AFFICHAGE_SAE_V2.ino, CONST_AFF_MDC.h]
2024-03-11 Les comantaires sont fait. Ne reste plus qu'a corriger le français!
    [CONST_AFF.h, CONST_AFF_BAT.h, CONST_AFF_MDC.h]
2024-03-13 Ajout du dossier CODE_DE_TEST
    [NoName1.cfg]
2024-03-13 Mise à jour des README.md
2024-03-15 Début de quelques modifications
2024-03-15 Juste quelques tests et des modifications
2024-03-15 J'ai commencé les comantaires
2024-03-22 Modification de l'affichage de Félix
2024-03-30 Update de la librairie GFX4D
2024-03-30 Ajout du schéma électrique de l'écran
2024-04-05 Création des ID de la DRIVE
2024-04-12 Création de l'affichage final
2024-04-13 Juste un code de test pour voir la fluidité de l'écran
2024-04-13 Fiche technique de la famille de l'écran
2024-04-24 Plus de fiche technique
2024-05-08 Effacer tout pour le nouveau schématic
    [PCB_MCP2515.PrjPcb, PCB_MCP_Final.PrjPcb, PCB_MCP_Final.SCHLIB, PCB_MCP_Final_BOM REV 1.00.xlsx, PCB_MCP_Final_PCB ASCII REV 1.00.PcbDoc, PCB_MCP_Final_PCB PNP XY REV 1.00.csv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]
2024-05-08 Fichier du PCB V2 Final
    [PCB_MCP_Final_PCB REV 2.00.GBL, PCB_MCP_Final_PCB REV 2.00.GBO, PCB_MCP_Final_PCB REV 2.00.GBP, PCB_MCP_Final_PCB REV 2.00.GBS, PCB_MCP_Final_PCB REV 2.00.GTL, PCB_MCP_Final_PCB REV 2.00.GTO, PCB_MCP_Final_PCB REV 2.00.GTP, PCB_MCP_Final_PCB REV 2.00.GTS]
2024-05-08 Suite des fichiers du PCB V2 Final
    [PCB_MCP_Final_BOM REV 2.00.xlsx, PCB_MCP_Final_PCB ASCII REV 2.00.PcbDoc, PCB_MCP_Final_PCB PNP XY REV 2.00.csv, PCB_MCP_Final_PCB REV 2.00.x_t]
2024-05-08 Fichier d'Altium
    [PCB_MCP_Final.PrjPcb, PCB_MCP_Final.SCHLIB, TEMPLATE_Circuit.SchDoc, TEMPLATE_PCB_2L.PcbDoc, TEMPLATE_Title.SchDoc, TEMPLATE_overview.SchDoc]
